OSURoboticsClub/aerial_avionics/README.md

Aerial Avionics
===============
_Hardware design files for aerial team avionics_
