OSURoboticsClub/aerial_avionics/(threads)

Thread 5 (2015-01-25):

Replace reset pullup with 4.7k resistor

yoos, 2015-01-25:
20k is too high

Thread 6 (2015-01-25):

Move 3.3V via out from under MPU-9250.

yoos, 2015-01-25:
The MPU-9250 has a large center pad which could short the 3.3V plane with GND. This would be bad.

yoos, 2016-01-28:
Done.

Closed 2016-01-28.

Thread 10 (2015-01-29):

Fix MPU-9250 footprint

yoos, 2015-01-29:
New package is 3x3x1mm QFN, unlike the 4x4x0.9mm QFN the MPU-6000 was.

yoos, 2016-01-28:
Done.

Closed 2016-01-28.

Thread 11 (2015-01-29):

Better connect component side sensor 3.3V plane to 3.3V bus

yoos, 2015-01-29:
Currently connected to copper side 3.3V plane by a pad 1 of MPU-9250. After cutting that trace to accommodate the MPU-6000, 3.3V plane is cut off. This plane should have been better connected anyway. Should be easier to do on 4-layer board.

Thread 13 (2015-02-02):

Replace uSD CD pullup with 1.5k resistor

yoos, 2015-02-02:
1.5k already used for I2C and USB, so might as well do this to reduce part count.

Thread 14 (2015-02-05):

Add LED button to indicate data save location

yoos, 2015-02-05:
Some flights are more worth saving than others. We should toggle this on the FC board with a button with LED feedback.

Thread 15 (2015-02-05):

Add LED button to arm/disarm board

yoos, 2015-02-05:
At least for rocket, need to be able to arm on pad. Thinking a stiff button accessible via a LED-lighted pinhole.

Thread 16 (2015-02-07):

Replace crystal oscillator with MEMS resonator

yoos, 2015-02-07:
MEMS resonators are temperature-compensated. They are more jittery, but we care more about long-term drift issues rather than small edge-to-edge clock jitter.

Thread 17 (2015-02-07):

Invert TX/RX LED logic levels

yoos, 2015-02-07:
UART is active low. TX/RX status LEDs should be inverted.

yoos, 2015-02-07:
Actually, no.

Closed 2015-02-07.

Thread 18 (2015-04-08):

Break out 3.3V on some pin

yoos, 2015-04-08:
We just have a bunch of 5V outputs. Maybe this should be the function of the PDB, but it's nice for debugging external peripherals.

Thread 19 (2015-04-08):

Reroute KILL bus to mechanical switch instead of XBee

yoos, 2015-04-08:
Also put digital outputs on KILL bus with DNP resistors.

yoos, 2016-04-05:
This was started to comply with IARC requirement. It's a dumb requirement.

Closed 2016-04-05.

Thread 21 (2015-04-14):

Add 100 Ohm series resistors to MOSI and SCK on SPI1 and SPI2

yoos, 2015-04-14:
Edges are overshooting by more than 800mV. The MS5611 and MPU-9050 on one of the boards died recently, and I suspect the overly strong line drivers in the F4. Adding resistors close to the F4 fixed the overshoot.

yoos, 2015-04-19:
Scoped unterminated lines with better probe, and there doesn't seem to be any ringing at all. I think the overshoot is just an artifact. That said, it's still not a bad idea to add them..

Thread 22 (2015-05-17):

Add series power FETs in line with servo output power rails

yoos, 2015-05-17:
Servos hold position when a previously active signal disappears. Without access to the internal circuitry, I can't think of an easier way to make a servo go limp.
