OSURoboticsClub/aerial_avionics/motor_controller/rev1/P1/esc_mod1_p1.pdf

D

6 | 5 | 4 | 3 | 2 | 1

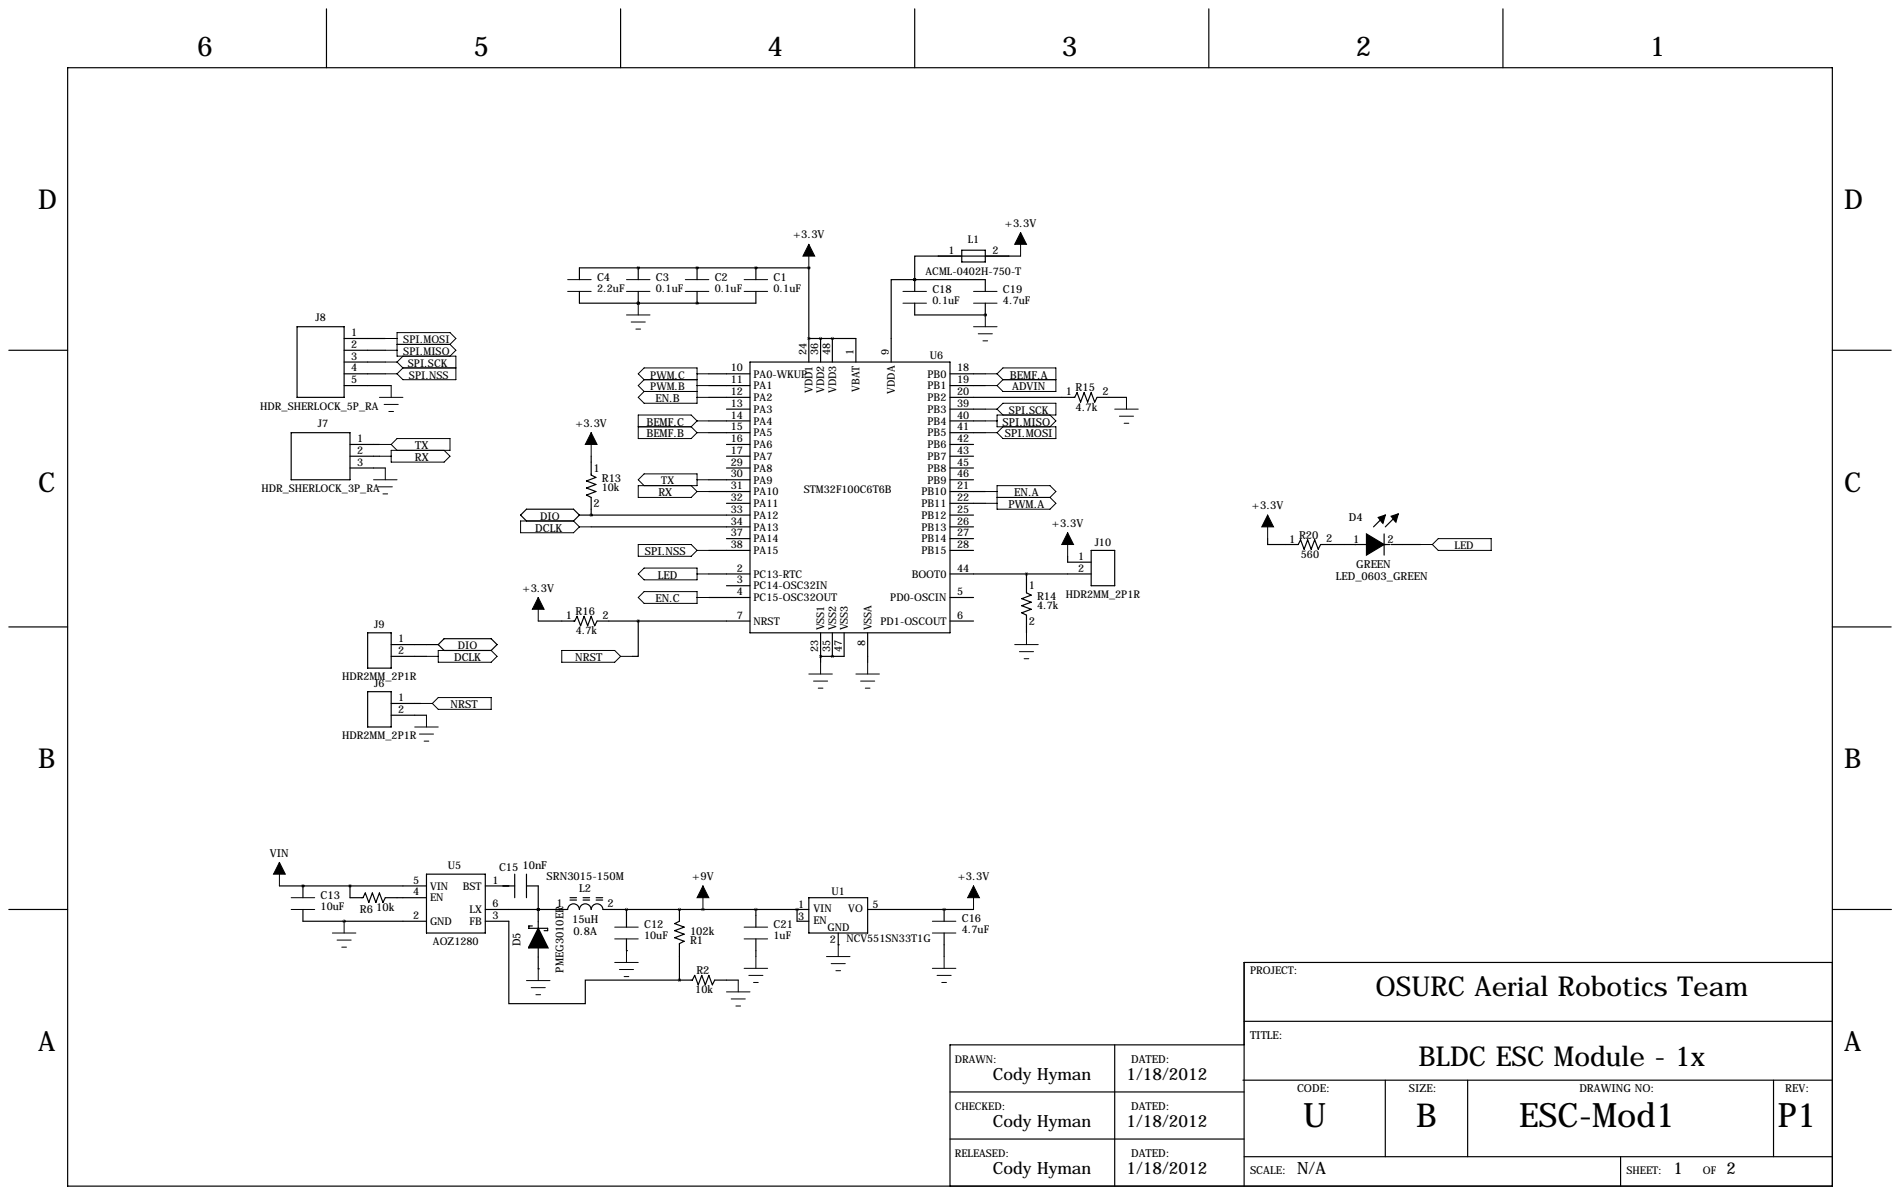
[picture p1: page 1]

OSURC Aerial Robotics Team

DRAWN: Cody Hyman | DATED: 1/18/2012

CODE: U | SIZE: B | DRAWING NO: ESC-Mod1 | REV: P1

CHECKED: Cody Hyman | DATED: 1/18/2012

RELEASED: Cody Hyman | DATED: 1/18/2012

N/A SCALE: | 1 2 SHEET: OF

# BACD

6

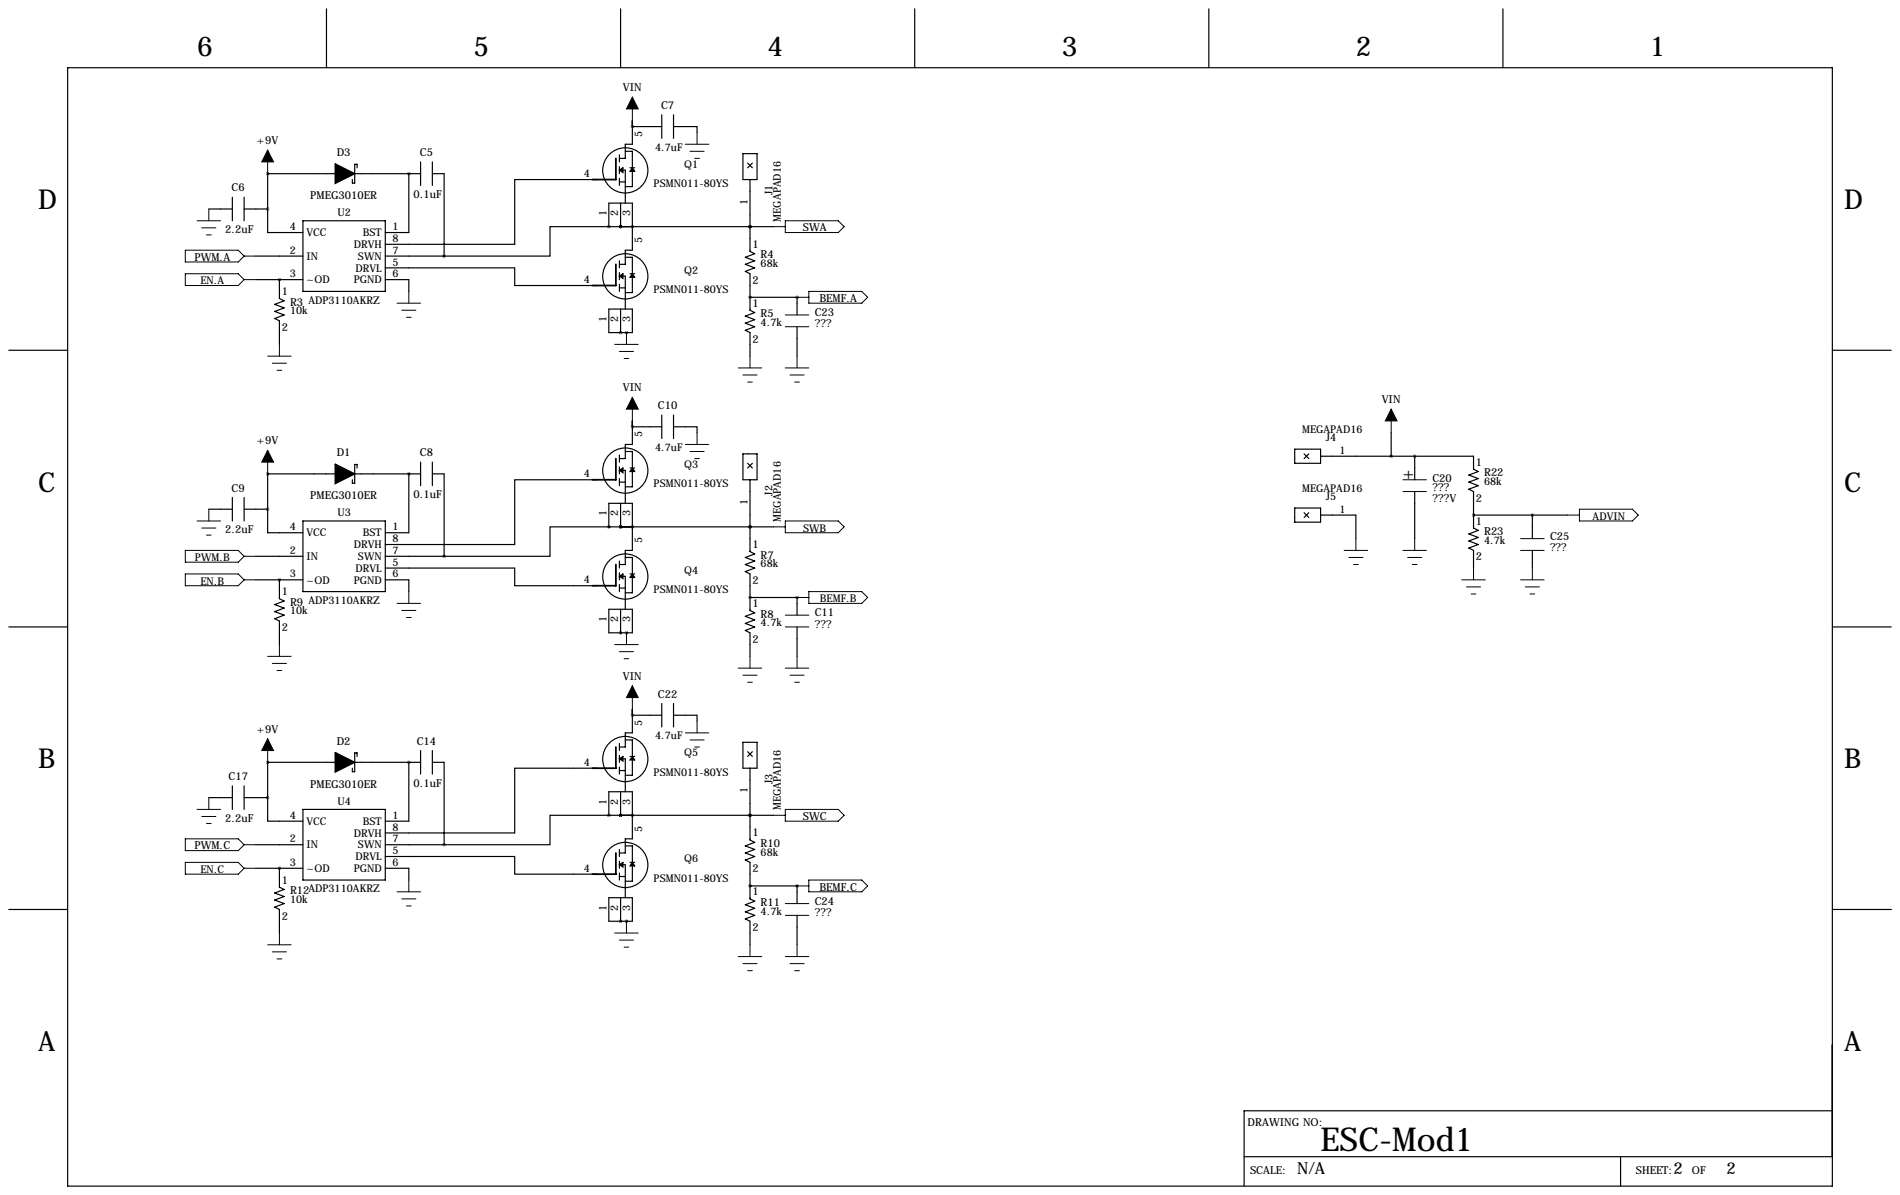
[picture p2: page 2]
