OSURoboticsClub/aerial_avionics/flight_controller/v3.9/core_v3.9_layout.pdf

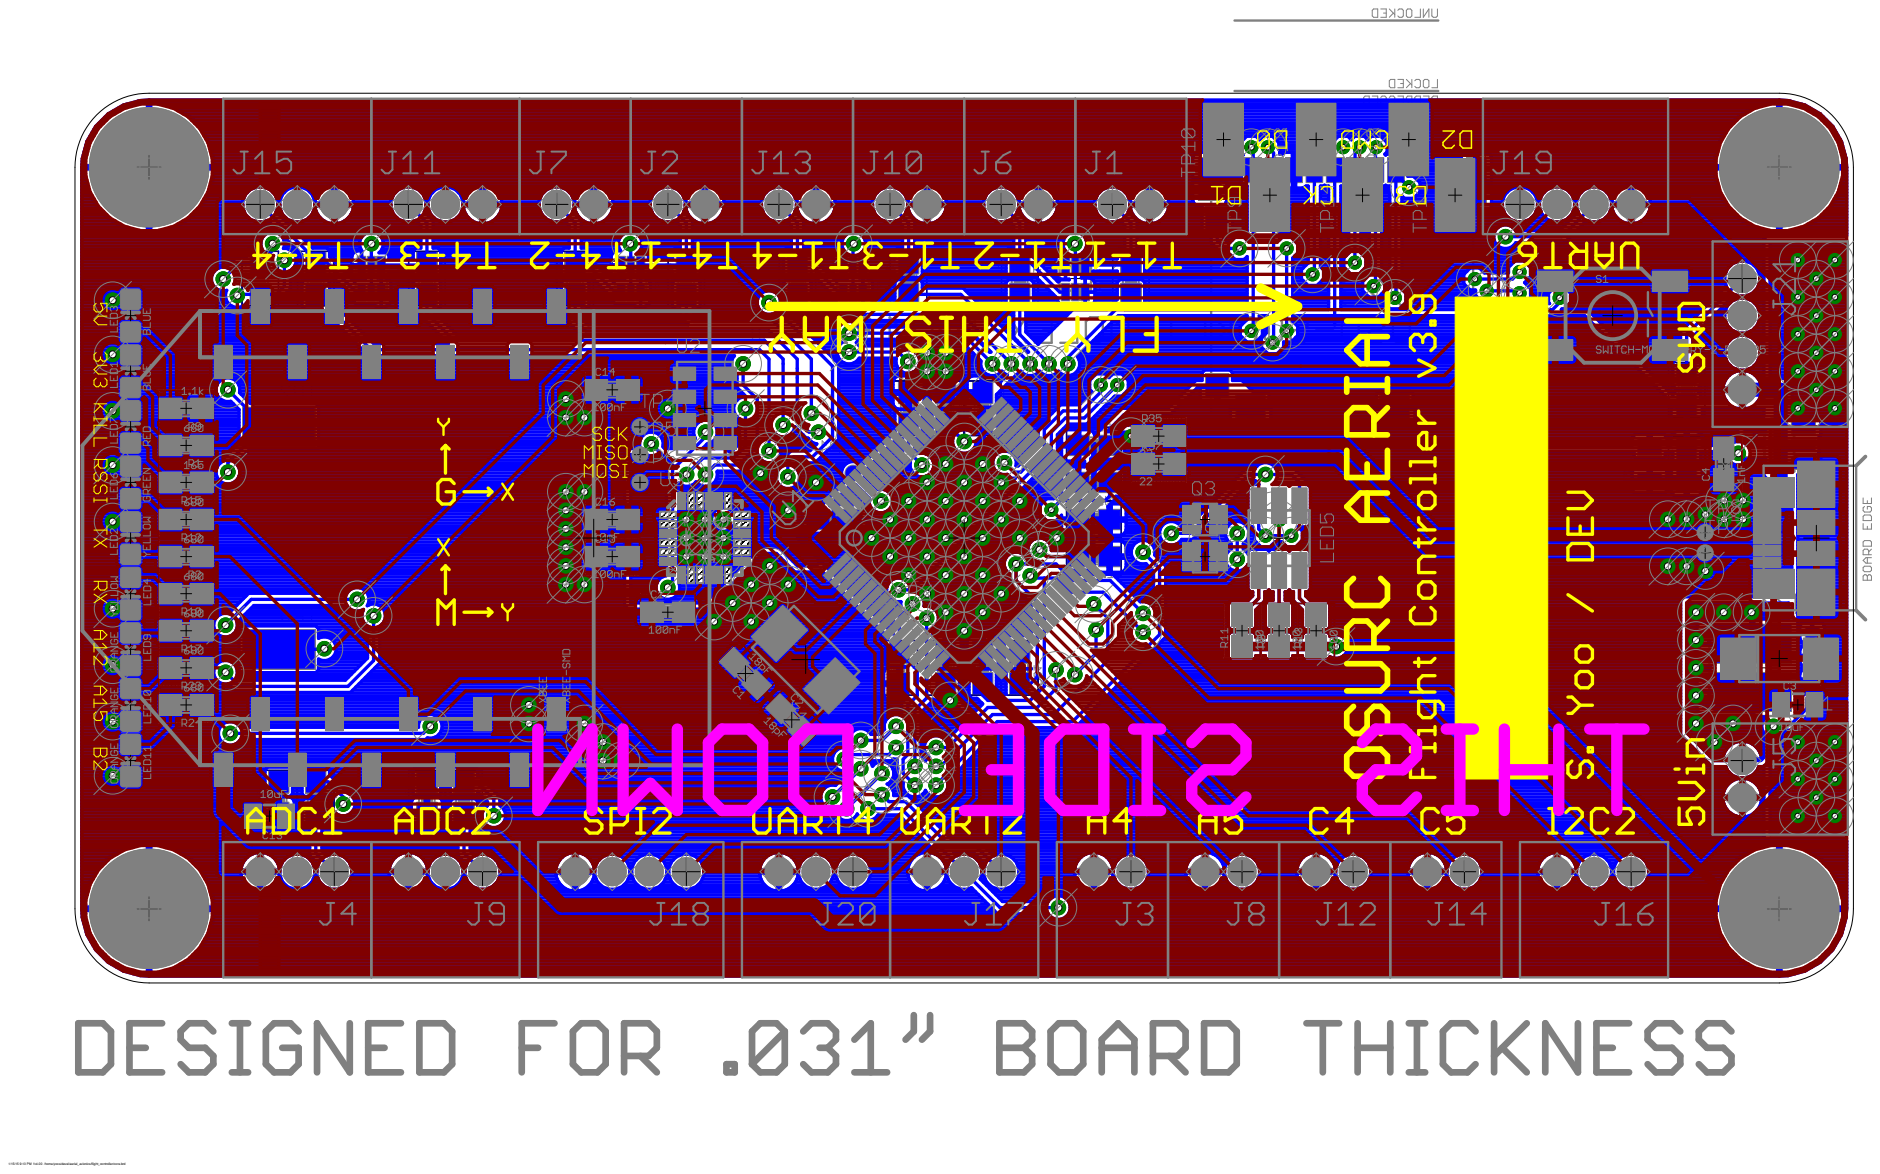
[picture p3: page 1]

1/15/15 9:13 PM f=4.00 /home/yoos/devel/aerial_avionics/flight_controller/core.brd
