OSURoboticsClub/aerial_avionics/flight_controller/v3.9/core_v3.9_sch.pdf

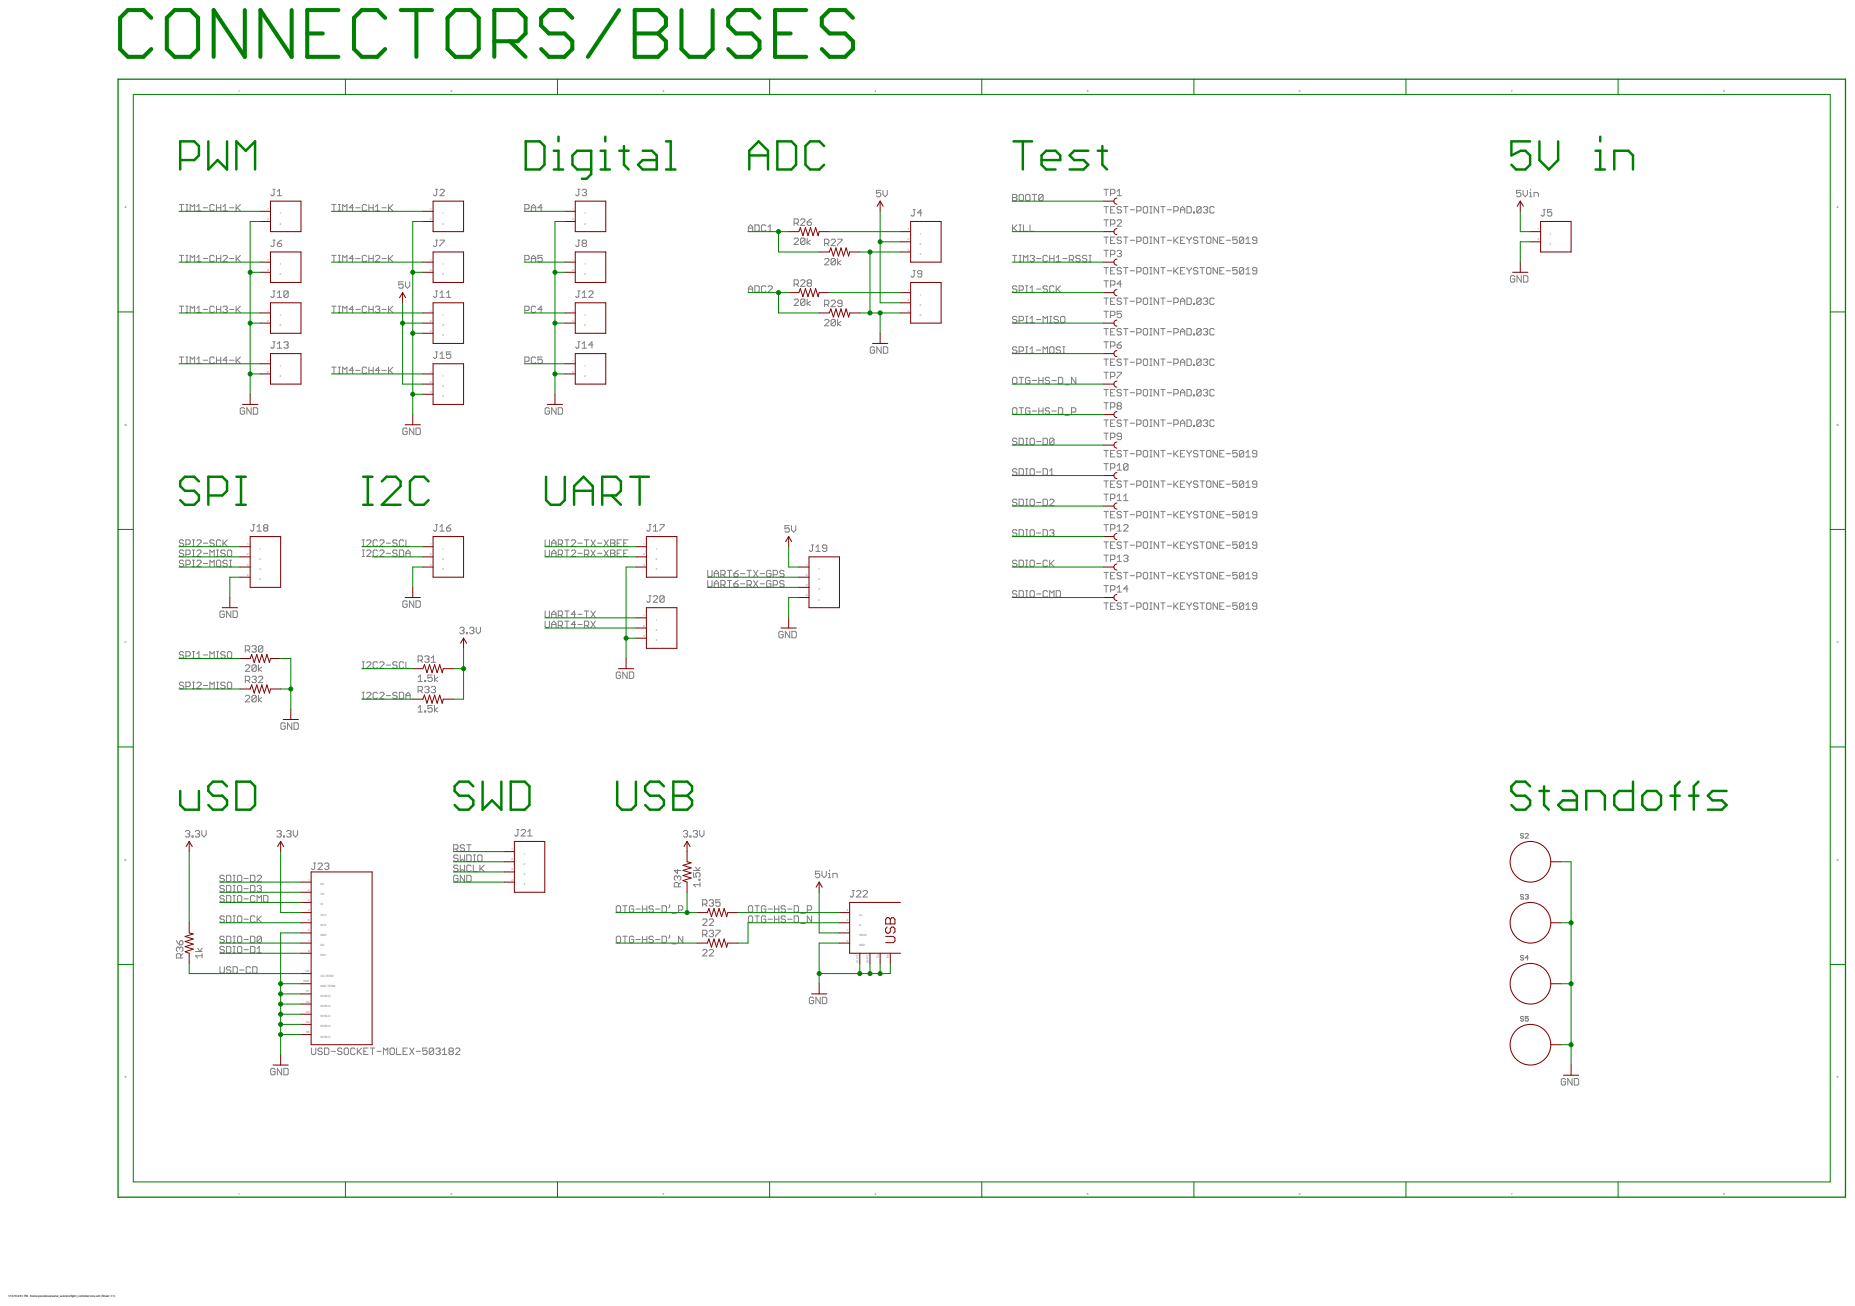
[picture p4: page 1]

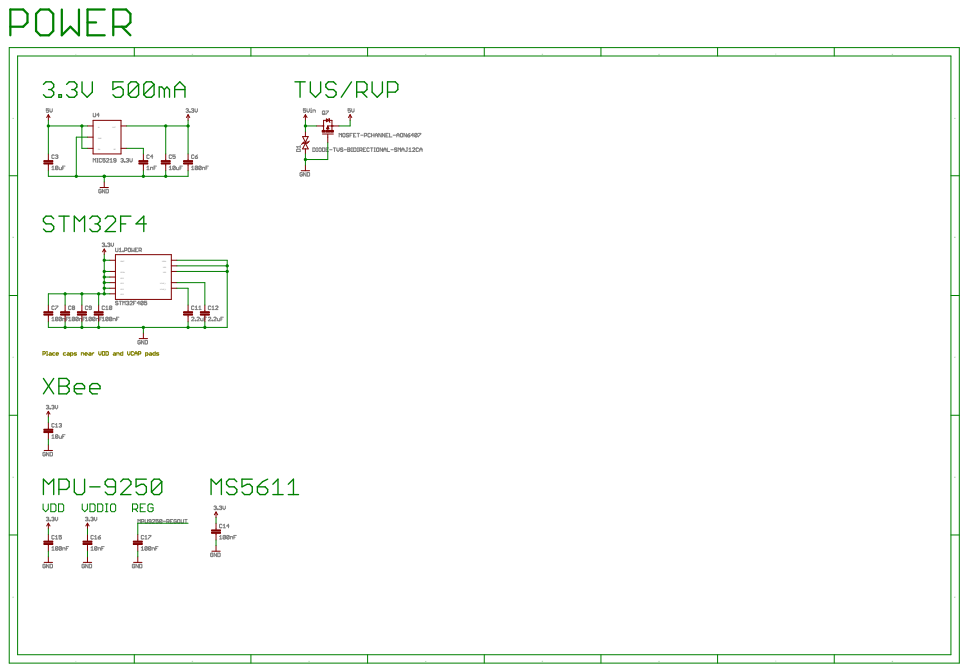
[picture p5: page 2]

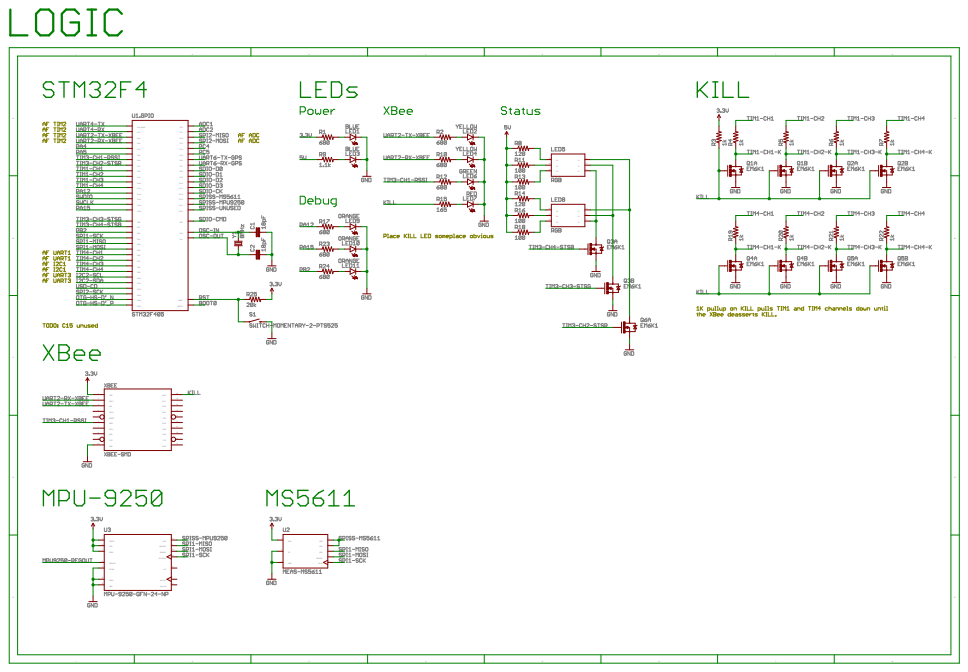
[picture p6: page 3]
