OSURoboticsClub/aerial_avionics/motor_controller/rev1/P1/esc_mod1_p1_layout.pdf

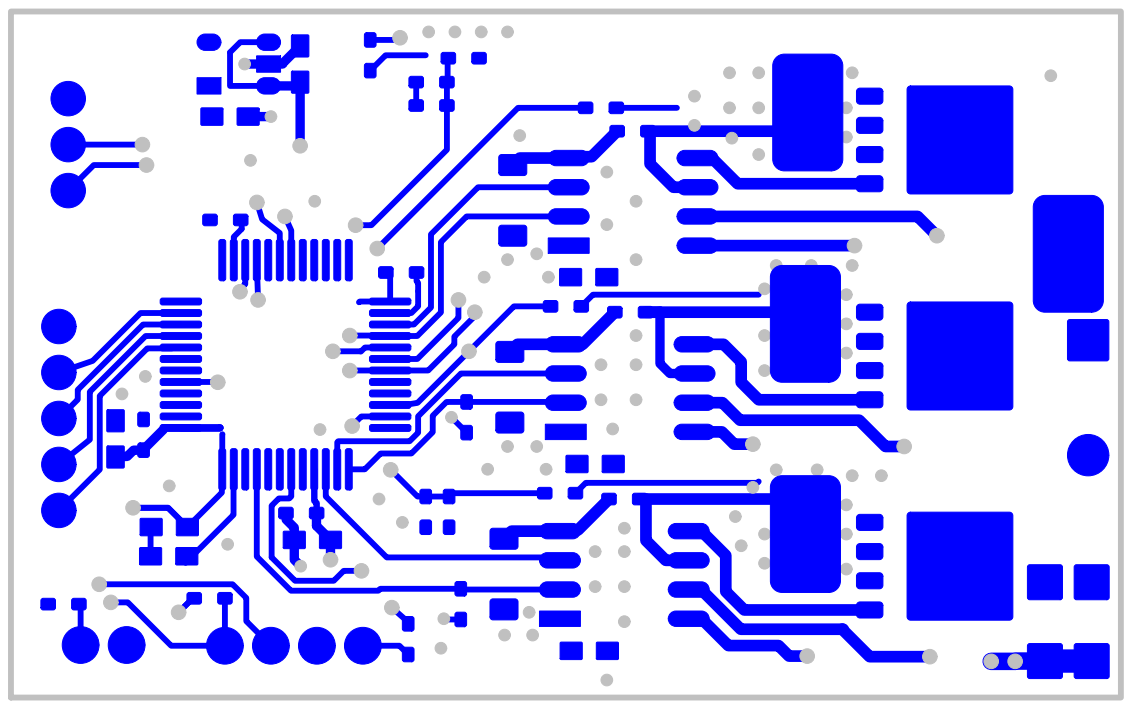
[picture p7: page 1]

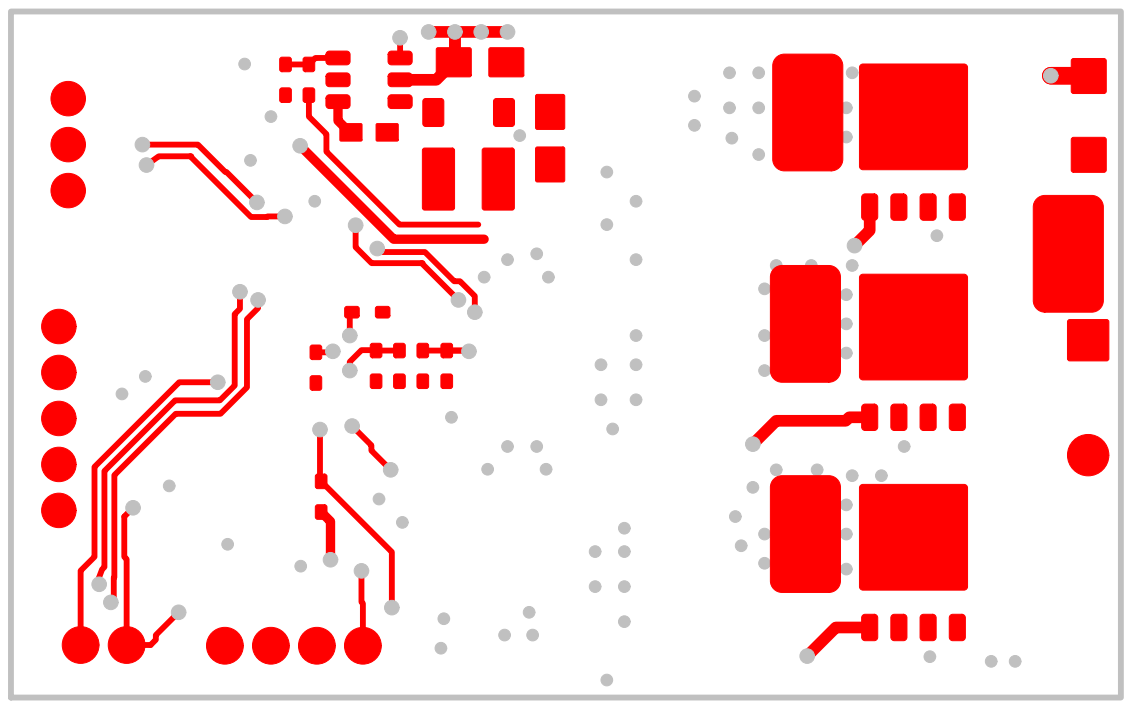
[picture p8: page 2]
U5U⁵x1 U⁵x2 U⁵x3; U⁵x4 U⁵x5 U⁵x6; C11C¹¹x1; C15C¹⁵x1; C¹⁵x2; C12C¹²x1 C¹²x2; C13C¹³x1; C¹³x2; C7C⁷x1 C⁷x2 C20C²⁰x1 C²⁰x2; Q2Q²x4; Q²x3; Q²x2; Q²x1 Q²x5; Q4Q⁴x4; Q⁴x3; Q⁴x2; Q⁴x1 Q⁴x5; Q6Q⁶x4; Q⁶x3; Q⁶x2; Q⁶x1 Q⁶x5; R1R¹x1; R3R³x1; R³x2; R5R⁵x1 R⁵x2; R8R⁸x1 R⁸x2; D5D⁵x1; D⁵x2; R15R¹⁵x1 R¹⁵x2

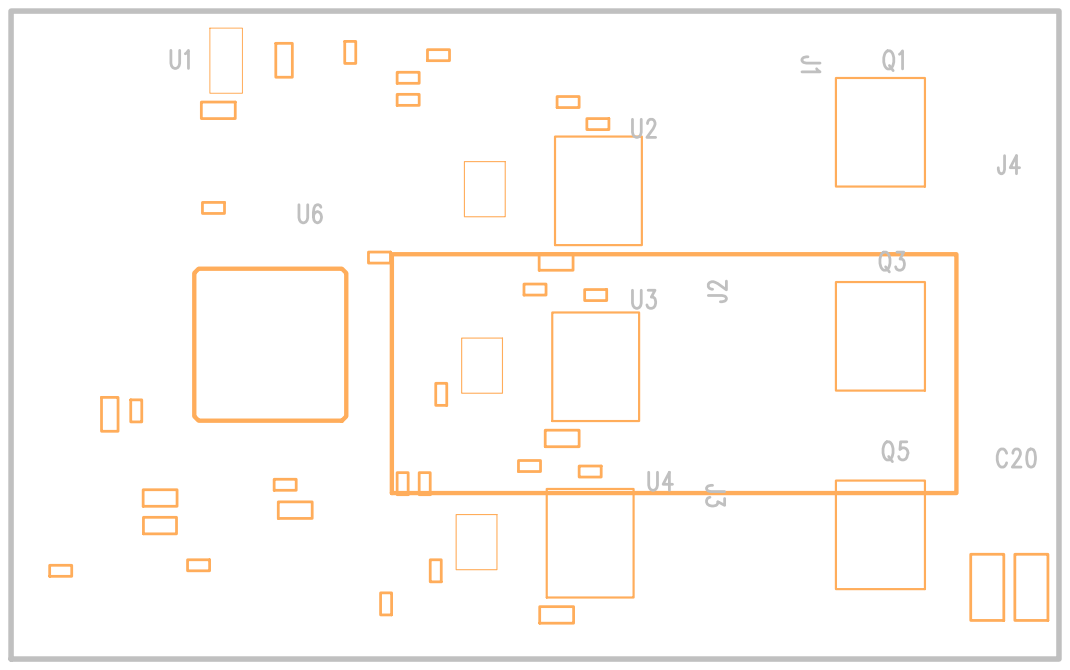
[picture p9: page 3]

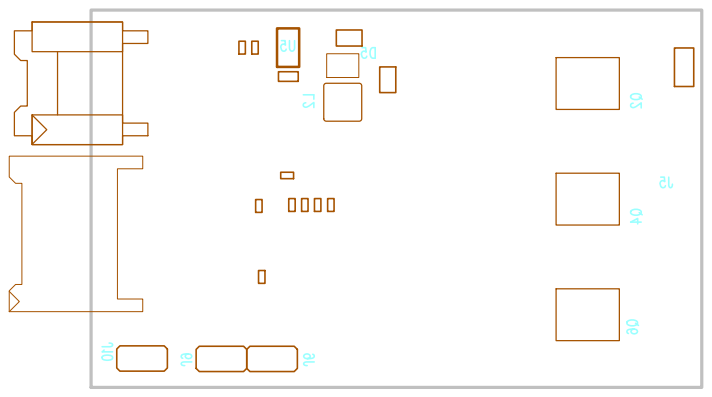
[picture p10: page 4]

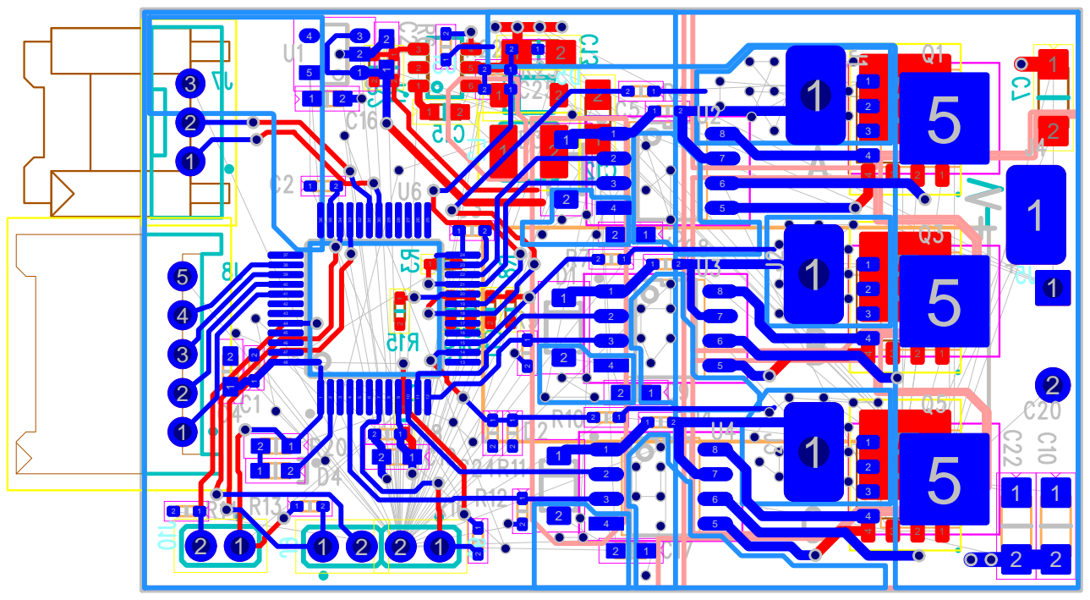
[picture p11: page 5]
