OSURoboticsClub/aerial_avionics/(list of files, drawings)

Other design files:
motor_controller/rev1/esc_mod1_p1.pcb
motor_controller/rev2/esc_mod1_p2.pcb
