OSURoboticsClub/aerial_avionics/power_distribution/osuar_pdb.brd

## EAGLE design power_distribution/osuar_pdb.brd (2016-01-24)

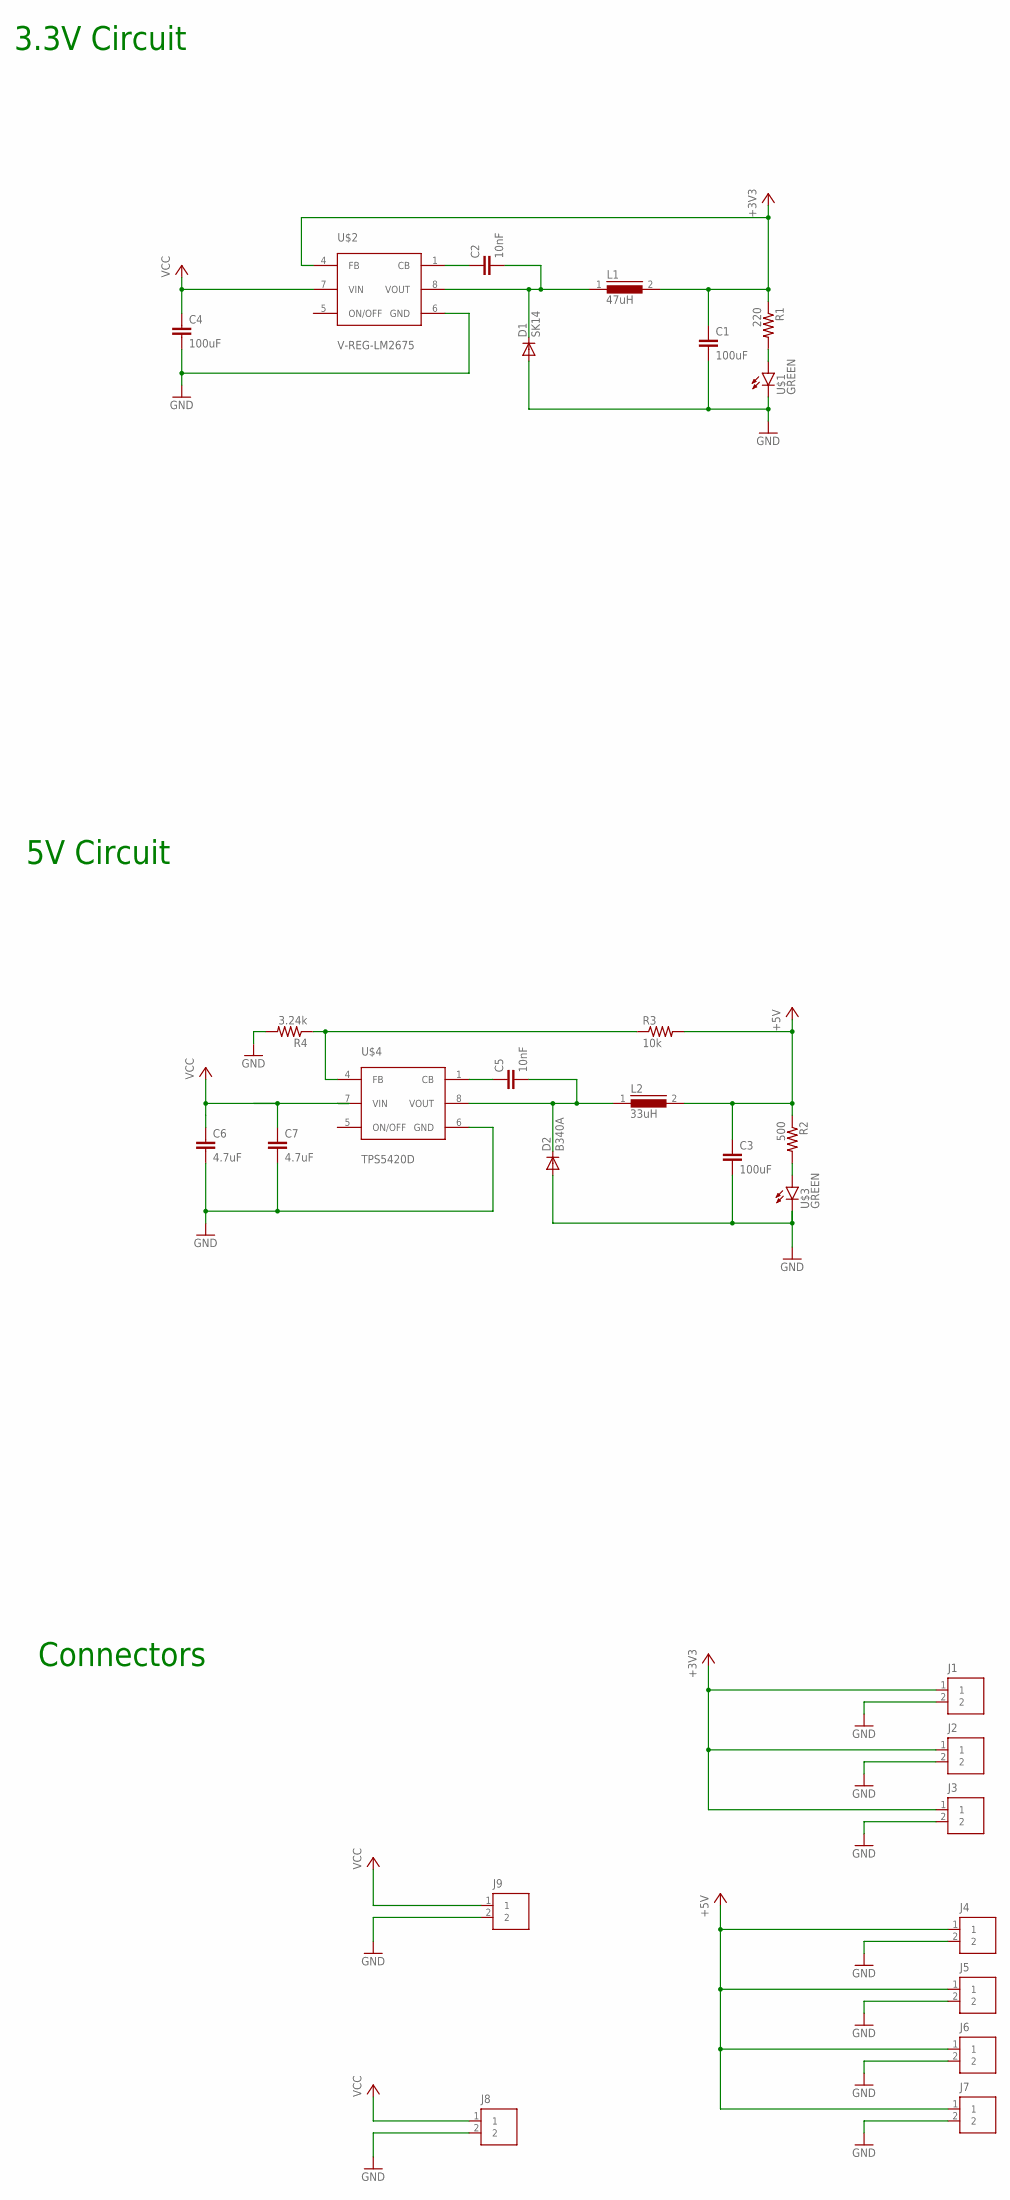
[picture p12: schematic osuar_pdb.sch, 3.3V Circuit]

Parts:
C1, C3, C4: 100uF; 0805
C2, C5: 10nF; 0603
C6, C7: 4.7uF; 0805
D1: SK14; DO214AA
D2: B340A; DO214AA
J1, J2, J3, J4, J5, J6, J7, J8, J9: M02; MOLEX-2MM-MICROLATCH-2POS-RA
L1: 47uH; DR125
L2: 33uH; DR125
R1: 220; 0603
R2: 500; 0603
R3: 10k; 0603
R4: 3.24k; 0603
U$1, U$3: GREEN; LED-0603
U$2: V-REG-LM2675; SOIC8
U$4: TPS5420D; SOIC8

Connections:
+3V3: C1.2, J1.1, J2.1, J3.1, L1.2, R1.1, U$2.4 (FB)
+5V: C3.2, J4.1, J5.1, J6.1, J7.1, L2.2, R2.1, R3.2
GND: C1.1, C3.1, C4.1, C6.1, C7.1, D1.A, D2.A, J1.2, J2.2, J3.2, J4.2, J5.2, J6.2, J7.2, J8.2, J9.2, R4.2, U$1.C, U$2.6 (GND), U$3.C, U$4.6 (GND)
unnamed: C5.1, D2.C, L2.1, U$4.8 (VOUT)
unnamed: C2.2, U$2.1 (CB)
unnamed: R1.2, U$1.A
unnamed: C5.2, U$4.1 (CB)
unnamed: C2.1, D1.C, L1.1, U$2.8 (VOUT)
unnamed: R2.2, U$3.A
unnamed: R3.1, R4.1, U$4.4 (FB)
VCC: C4.2, C6.2, C7.2, J8.1, J9.1, U$2.7 (VIN), U$4.7 (VIN)

Notes on the sheet:
3.3V Circuit
5V Circuit
Connectors

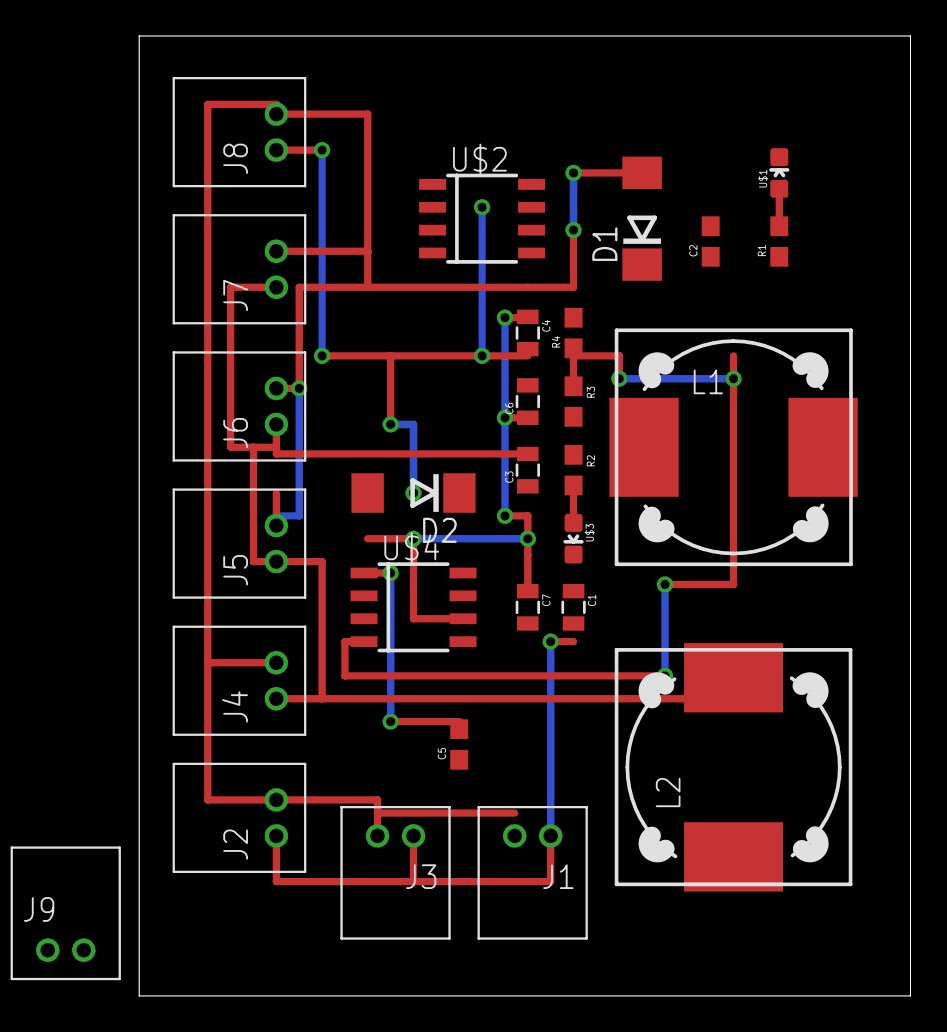
[picture p13: board osuar_pdb.brd from above]

Board: 2 copper layers, 42.9 x 53.3 mm, 28 parts (0 on the bottom side), 11 nets.
