OSURoboticsClub/aerial_avionics/flight_controller/v3.9.1/core.brd

## EAGLE design flight_controller/v3.9.1/core.brd (2016-01-24)

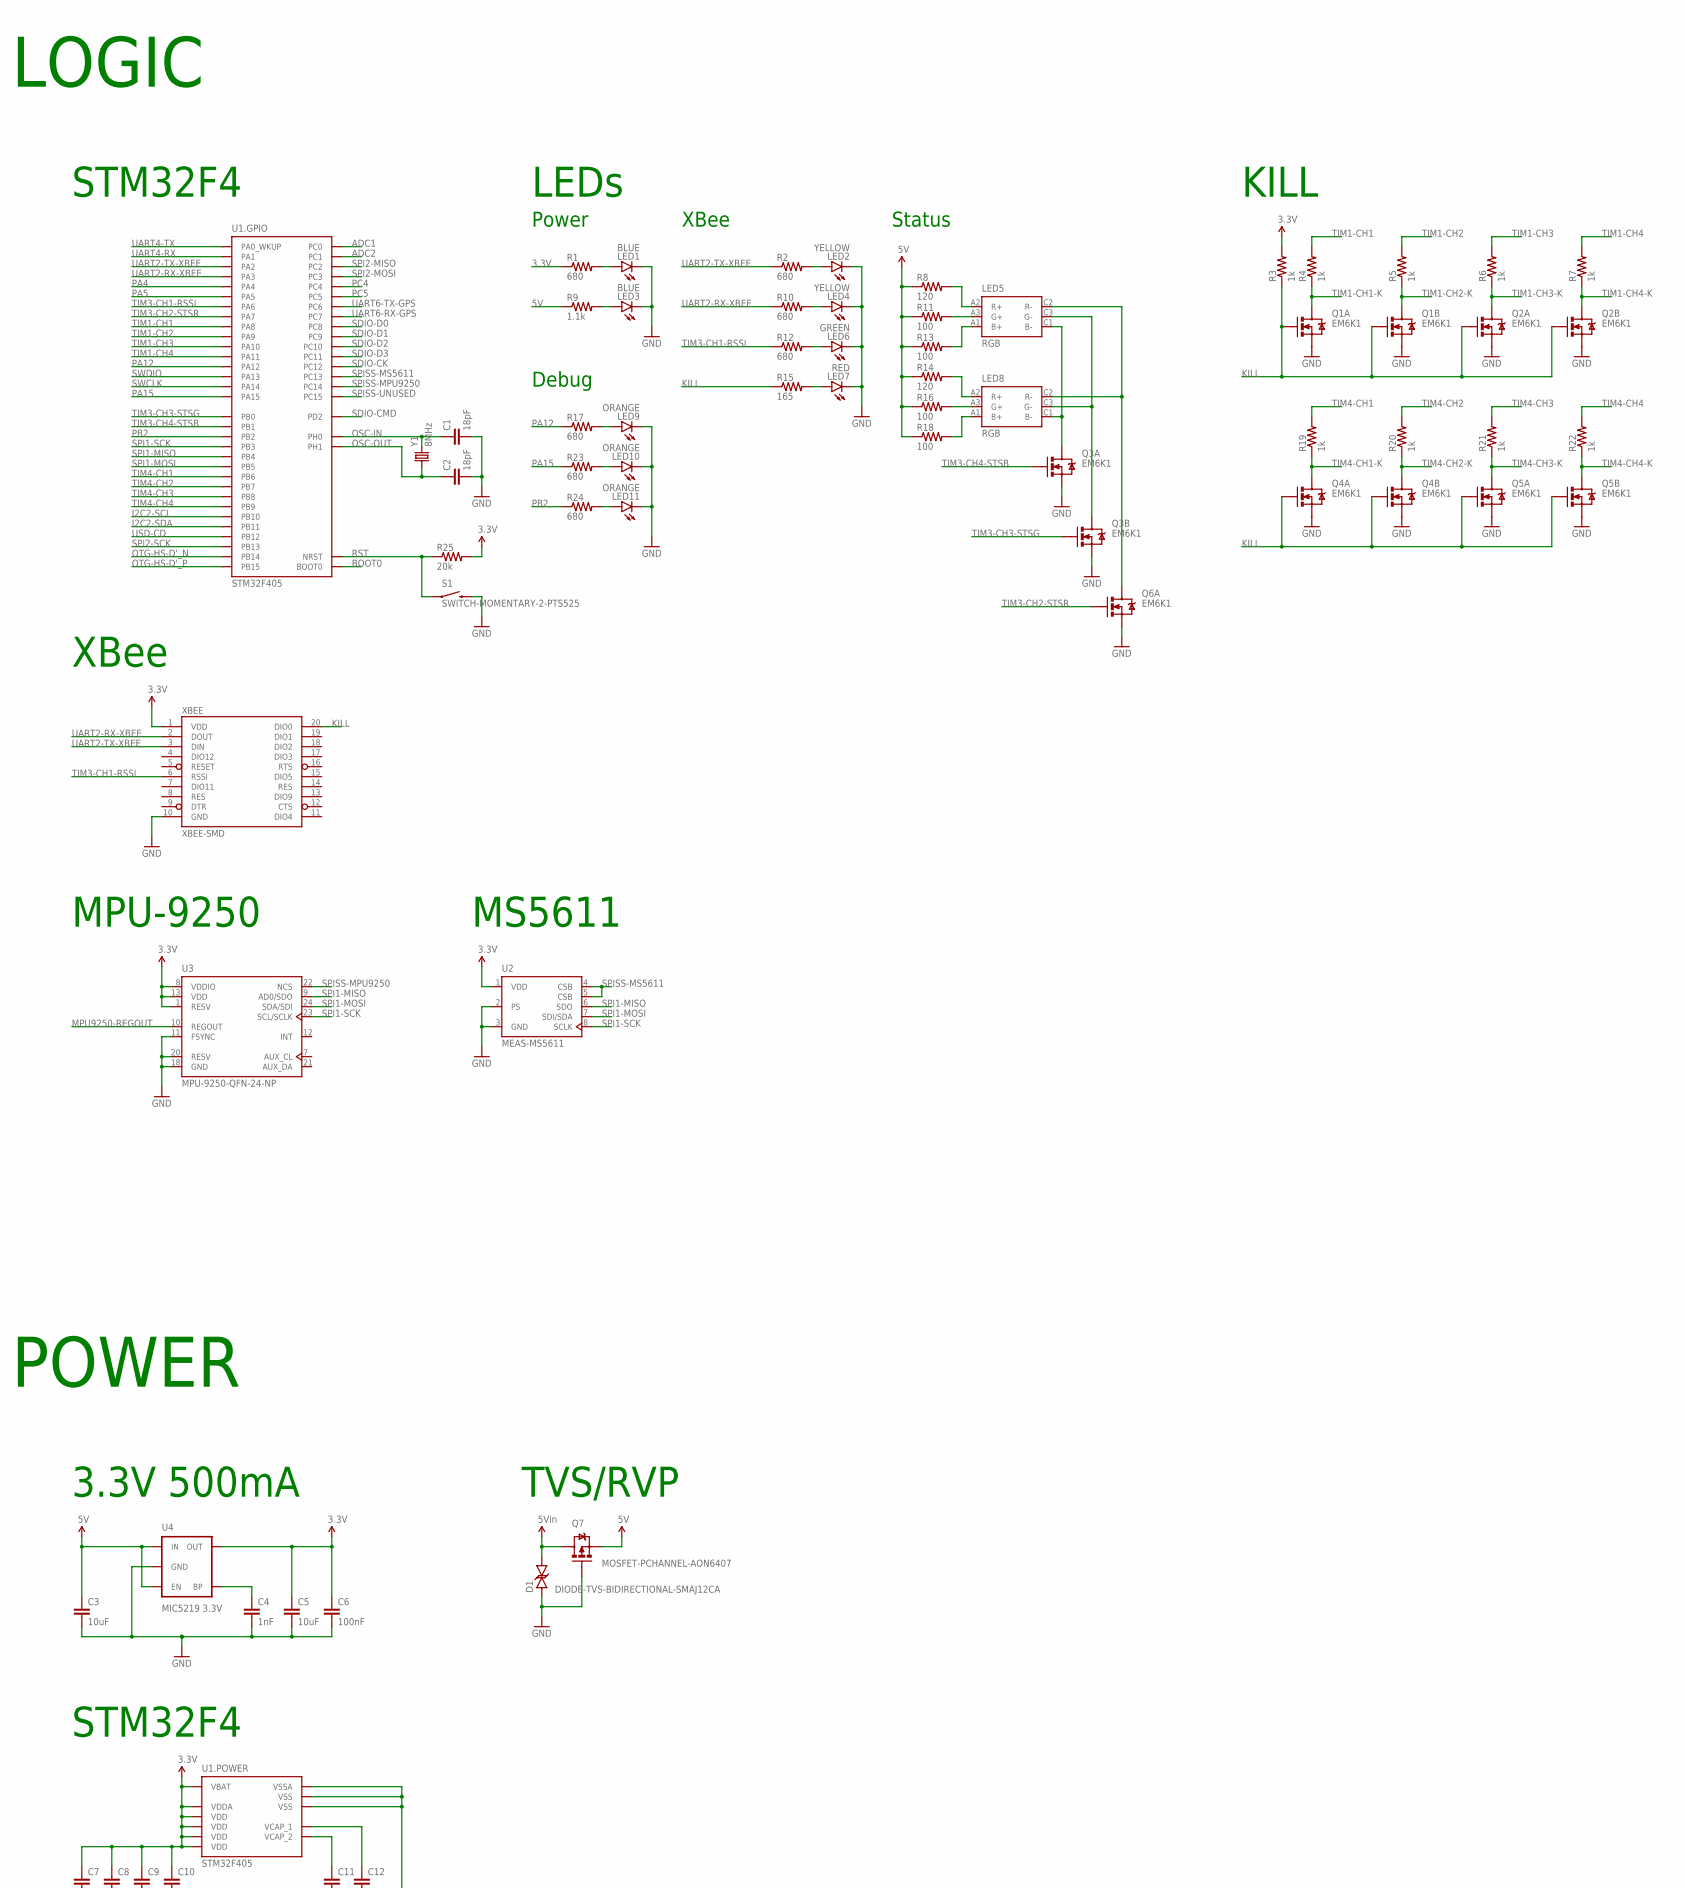
[picture p14: schematic core.sch, part in row 1, column 1]

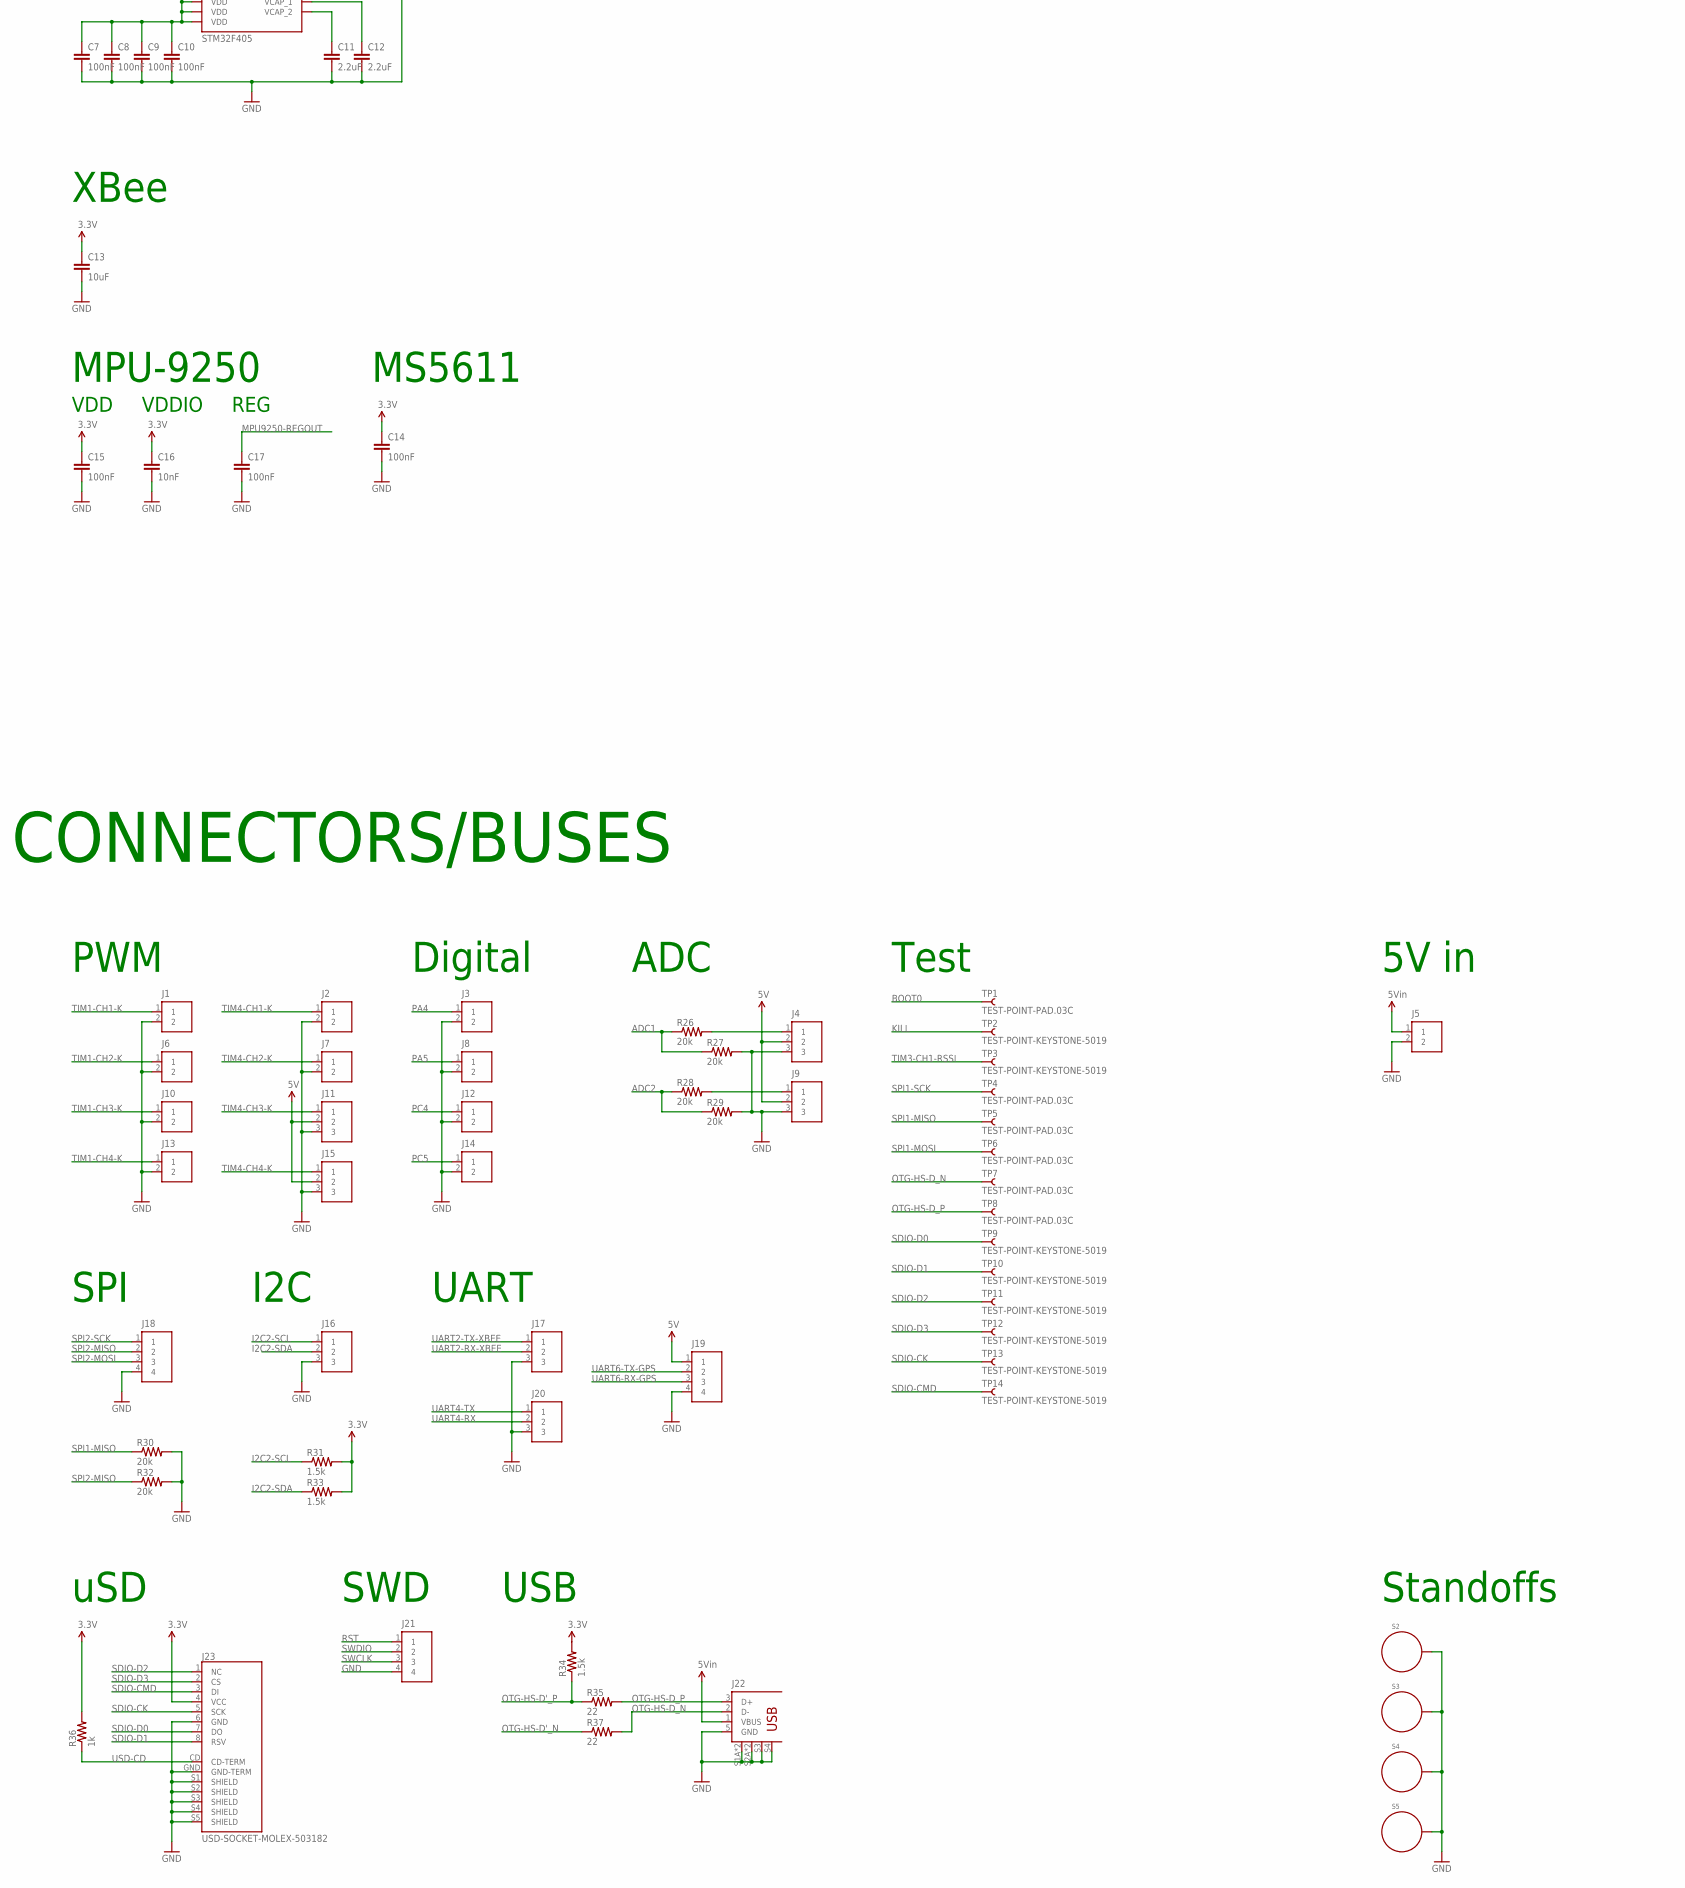
[picture p15: schematic core.sch, part in row 2, column 1]

Parts:
C1, C2: 18pF; 0603
C3, C5, C13: 10uF; 0805
C4: 1nF; 0603
C6, C7, C8, C9, C10, C14, C15, C17: 100nF; 0603
C11, C12: 2.2uF; 0603
C16: 10nF; 0603
D1: DIODE-TVS-BIDIRECTIONAL-SMAJ12CA; SMAJ
J1, J2, J3, J5, J6, J7, J8, J10, J12, J13, J14: M02; MOLEX-2MM-MICROLATCH-2POS-RA
J4, J9, J11, J15, J16, J17, J20: M03; MOLEX-2MM-MICROLATCH-3POS-RA
J18, J19, J21: M04; MOLEX-2MM-MICROLATCH-4POS-RA
J22: USB+SHIELD-MICROB-SMD-MOLEX; USB-MICROB-SMD-MOLEX
J23: USD-SOCKET-MOLEX-503182; USD-SOCKET-PP-MOLEX-503182
LED1, LED3: BLUE; LED-0603
LED2, LED4: YELLOW; LED-0603
LED5, LED8: RGB; PLCC-6
LED6: GREEN; LED-0603
LED7: RED; LED-0603
LED9, LED10, LED11: ORANGE; LED-0603
Q1, Q2, Q3, Q4, Q5, Q6: EM6K1; SOT-666
Q7: MOSFET-PCHANNEL-AON6407; DFN5X6
R1, R2, R10, R12, R17, R23, R24: 680; 0603
R3, R4, R5, R6, R7, R19, R20, R21, R22, R36: 1k; 0603
R8, R14: 120; 0603
R9: 1.1k; 0603
R11, R13, R16, R18: 100; 0603
R15: 165; 0603
R25, R26, R27, R28, R29, R30, R32: 20k; 0603
R31, R33, R34: 1.5k; 0603
R35, R37: 22; 0603
S1: SWITCH-MOMENTARY-2-PTS525; TACTILE-SWITCH-SMD
S2, S3, S4, S5: STANDOFF_ELECTRICAL-#4; STANDOFF-ELECTRICAL-#4
TP1, TP4, TP5, TP6, TP7, TP8: TEST-POINT-PAD.03C; PAD-.03C
TP2, TP3, TP9, TP10, TP11, TP12, TP13, TP14: TEST-POINT-KEYSTONE-5019; PAD.15X.08
U1: STM32F405; LQFP-64-STM32F405
U2: MEAS-MS5611
U3: MPU-9250-QFN-24-NP; QFN-24-NP-3X3MM
U4: MIC5219 3.3V; SOT23-5
XBEE: XBEE-SMD
Y1: 8MHz; CX532

Connections:
3.3V: C5.2, C6.2, C7.2, C8.2, C9.2, C10.2, C13.2, C14.2, C15.2, C16.2, J23.4 (VCC), R1.1, R3.2, R25.2, R31.2, R33.2, R34.2, R36.2, U1.1 (VBAT), U1.13 (VDDA), U1.19 (VDD), U1.32 (VDD), U1.48 (VDD), U1.64 (VDD), U2.1 (VDD), U3.1 (RESV), U3.8 (VDDIO), U3.13 (VDD), U4.5 (OUT), XBEE.1 (VDD)
5V: C3.2, J4.2, J9.2, J11.2, J15.2, J19.1, Q7.1 (S), Q7.2 (S), Q7.3 (S), R8.1, R9.1, R11.1, R13.1, R14.1, R16.1, R18.1, U4.1 (IN), U4.3 (EN)
ADC1: R26.1, R27.1, U1.8 (PC0)
ADC1-IN: J4.1, R26.2
ADC2: R28.1, R29.1, U1.9 (PC1)
ADC2-IN: J9.1, R28.2
BOOT0: TP1.1, U1.60 (BOOT0)
F4-VCAP-1: C11.2, U1.47 (VCAP_2)
F4-VCAP-2: C12.2, U1.31 (VCAP_1)
GND: C1.1, C2.1, C3.1, C4.1, C5.1, C6.1, C7.1, C8.1, C9.1, C10.1, C11.1, C12.1, C13.1, C14.1, C15.1, C16.1, C17.1, D1.A (1), J1.2, J2.2, J3.2, J4.3, J5.2, J6.2, J7.2, J8.2, J9.3, J10.2, J11.3, J12.2, J13.2, J14.2, J15.3, J16.3, J17.3, J18.4, J19.4, J20.3, J21.4, J22.5 (GND), J22.S1A (S1), J22.S1B (S1), J22.S2A (S2), J22.S2B (S2), J22.S3, J22.S4, J23.6 (GND), J23.GND (GND-TERM), J23.S1 (SHIELD), J23.S2 (SHIELD), J23.S3 (SHIELD), J23.S4 (SHIELD), J23.S5 (SHIELD), LED1.C, LED2.C, LED3.C, LED4.C, LED6.C, LED7.C, LED9.C, LED10.C, LED11.C, Q1.1 (S), Q1.4 (S), Q2.1 (S), Q2.4 (S), Q3.1 (S), Q3.4 (S), Q4.1 (S), Q4.4 (S), Q5.1 (S), Q5.4 (S), Q6.1 (S), Q7.4 (G), R27.2, R29.2, R30.2, R32.2, S1.3 (2), S1.4 (2), S2.P1, S3.P1, S4.P1, S5.P1, U1.12 (VSSA), U1.18 (VSS), U1.63 (VSS), U2.2 (PS), U2.3 (GND), U3.11 (FSYNC), U3.18 (GND), U3.20 (RESV), U4.2 (GND), XBEE.10 (GND)
I2C2-SCL: J16.1, R31.1, U1.29 (PB10)
I2C2-SDA: J16.2, R33.1, U1.30 (PB11)
KILL: Q1.2 (G), Q1.5 (G), Q2.2 (G), Q2.5 (G), Q4.2 (G), Q4.5 (G), Q5.2 (G), Q5.5 (G), R3.1, R15.1, TP2.1, XBEE.20 (DIO0)
MIC-BP: C4.2, U4.4 (BP)
MPU9250-REGOUT: C17.2, U3.10 (REGOUT)
unnamed: LED9.A, R17.2
unnamed: LED10.A, R23.2
unnamed: LED11.A, R24.2
unnamed: LED6.A, R12.2
unnamed: LED7.A, R15.2
unnamed: LED2.A, R2.2
unnamed: LED4.A, R10.2
unnamed: LED1.A, R1.2
unnamed: LED3.A, R9.2
OSC-IN: C1.2, U1.5 (PH0), Y1.2
OSC-OUT: C2.2, U1.6 (PH1), Y1.1
OTG-HS-D'_N: R37.1, U1.35 (PB14)
OTG-HS-D'_P: R34.1, R35.1, U1.36 (PB15)
OTG-HS-D_N: J22.2 (D-), R37.2, TP7.1
OTG-HS-D_P: J22.3 (D+), R35.2, TP8.1
PA4: J3.1, U1.20 (PA4)
PA5: J8.1, U1.21 (PA5)
PA12: R17.1, U1.45 (PA12)
PA15: R23.1, U1.50 (PA15)
PB2: R24.1, U1.28 (PB2)
PC4: J12.1, U1.24 (PC4)
PC5: J14.1, U1.25 (PC5)
RST: J21.1, R25.1, S1.1, S1.2 (1), U1.7 (NRST)
SDIO-CK: J23.5 (SCK), TP13.1, U1.53 (PC12)
SDIO-CMD: J23.3 (DI), TP14.1, U1.54 (PD2)
SDIO-D0: J23.7 (DO), TP9.1, U1.39 (PC8)
SDIO-D1: J23.8 (RSV), TP10.1, U1.40 (PC9)
SDIO-D2: J23.1 (NC), TP11.1, U1.51 (PC10)
SDIO-D3: J23.2 (CS), TP12.1, U1.52 (PC11)
SPI1-MISO: R30.1, TP5.1, U1.56 (PB4), U2.6 (SDO), U3.9 (AD0/SDO)
SPI1-MOSI: TP6.1, U1.57 (PB5), U2.7 (SDI/SDA), U3.24 (SDA/SDI)
SPI1-SCK: TP4.1, U1.55 (PB3), U2.8 (SCLK), U3.23 (SCL/SCLK)
SPI2-MISO: J18.2, R32.1, U1.10 (PC2)
SPI2-MOSI: J18.3, U1.11 (PC3)
SPI2-SCK: J18.1, U1.34 (PB13)
SPISS-MPU9250: U1.3 (PC14), U3.22 (NCS)
SPISS-MS5611: U1.2 (PC13), U2.4 (CSB), U2.5 (CSB)
SPISS-UNUSED: U1.4 (PC15)
STSB1+: LED5.A1 (B+), R13.2
STSB2+: LED8.A1 (B+), R18.2
STSB-: LED5.C1 (B-), LED8.C1 (B-), Q3.6 (D)
STSG1+: LED5.A3 (G+), R11.2
STSG2+: LED8.A3 (G+), R16.2
STSG-: LED5.C3 (G-), LED8.C3 (G-), Q3.3 (D)
STSR1+: LED5.A2 (R+), R8.2
STSR2+: LED8.A2 (R+), R14.2
STSR-: LED5.C2 (R-), LED8.C2 (R-), Q6.6 (D)
SWCLK: J21.3, U1.49 (PA14)
SWDIO: J21.2, U1.46 (PA13)
TIM1-CH1: R4.2, U1.41 (PA8)
TIM1-CH1-K: J1.1, Q1.6 (D), R4.1
TIM1-CH2: R5.2, U1.42 (PA9)
TIM1-CH2-K: J6.1, Q1.3 (D), R5.1
TIM1-CH3: R6.2, U1.43 (PA10)
TIM1-CH3-K: J10.1, Q2.6 (D), R6.1
TIM1-CH4: R7.2, U1.44 (PA11)
TIM1-CH4-K: J13.1, Q2.3 (D), R7.1
TIM3-CH1-RSSI: R12.1, TP3.1, U1.22 (PA6), XBEE.6 (RSSI)
TIM3-CH2-STSR: Q6.2 (G), U1.23 (PA7)
TIM3-CH3-STSG: Q3.5 (G), U1.26 (PB0)
TIM3-CH4-STSB: Q3.2 (G), U1.27 (PB1)
TIM4-CH1: R19.2, U1.58 (PB6)
TIM4-CH1-K: J2.1, Q4.6 (D), R19.1
TIM4-CH2: R20.2, U1.59 (PB7)
TIM4-CH2-K: J7.1, Q4.3 (D), R20.1
TIM4-CH3: R21.2, U1.61 (PB8)
TIM4-CH3-K: J11.1, Q5.6 (D), R21.1
TIM4-CH4: R22.2, U1.62 (PB9)
TIM4-CH4-K: J15.1, Q5.3 (D), R22.1
UART2-RX-XBEE: J17.2, R10.1, U1.17 (PA3), XBEE.2 (DOUT)
UART2-TX-XBEE: J17.1, R2.1, U1.16 (PA2), XBEE.3 (DIN)
UART4-RX: J20.2, U1.15 (PA1)
UART4-TX: J20.1, U1.14 (PA0_WKUP)
UART6-RX-GPS: J19.3, U1.38 (PC7)
UART6-TX-GPS: J19.2, U1.37 (PC6)
USD-CD: J23.CD (CD-TERM), R36.1, U1.33 (PB12)
VIN: D1.C (2), J5.1, J22.1 (VBUS), Q7.5 (D), Q7.6 (D), Q7.7 (D), Q7.8 (D), Q7.9 (D), Q7.10 (D)

Notes on the sheet:
3.3V 500mA
XBee
ADC
UART
PWM
SWD
KILL
STM32F4
LOGIC
POWER
USB
uSD
CONNECTORS/BUSES
LEDs
Debug
Power
MPU-9250
MS5611
SPI
I2C
Status
5V in
TVS/RVP
VDD
REG
VDDIO
Digital
Test
Standoffs

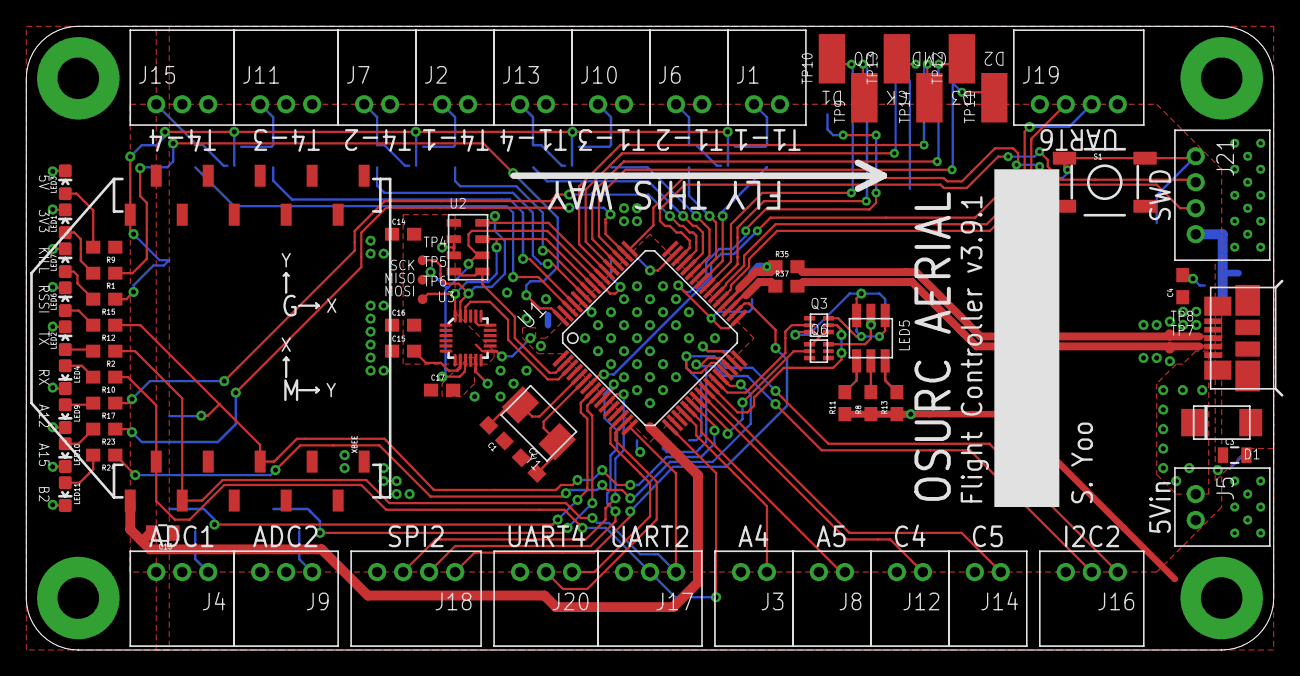
[picture p16: board core.brd from above]

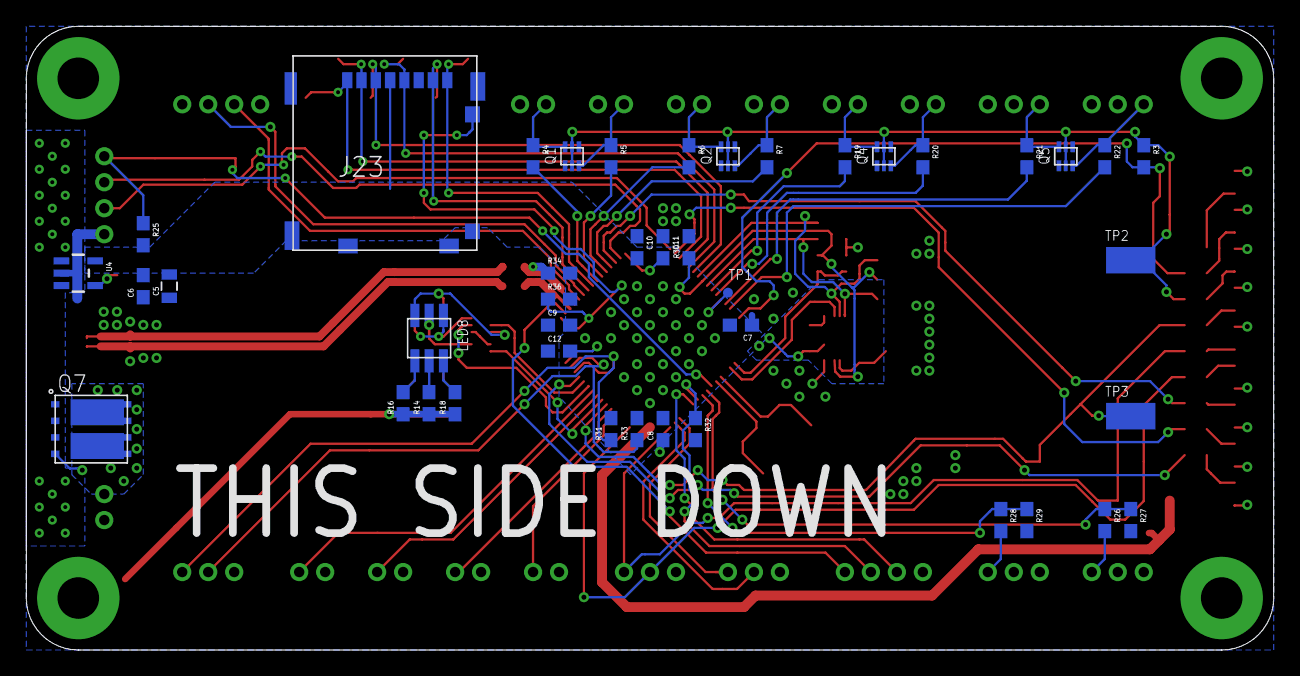
[picture p17: board core.brd from below]

Board: 2 copper layers, 96.0 x 48.0 mm, 121 parts (42 on the bottom side), 91 nets.
