OSURoboticsClub/aerial_avionics/flight_controller/rev2/was_not_root_aerialboard_rev1.brd

## EAGLE design flight_controller/rev2/was_not_root_aerialboard_rev1.brd (2014-11-05, an earlier design)

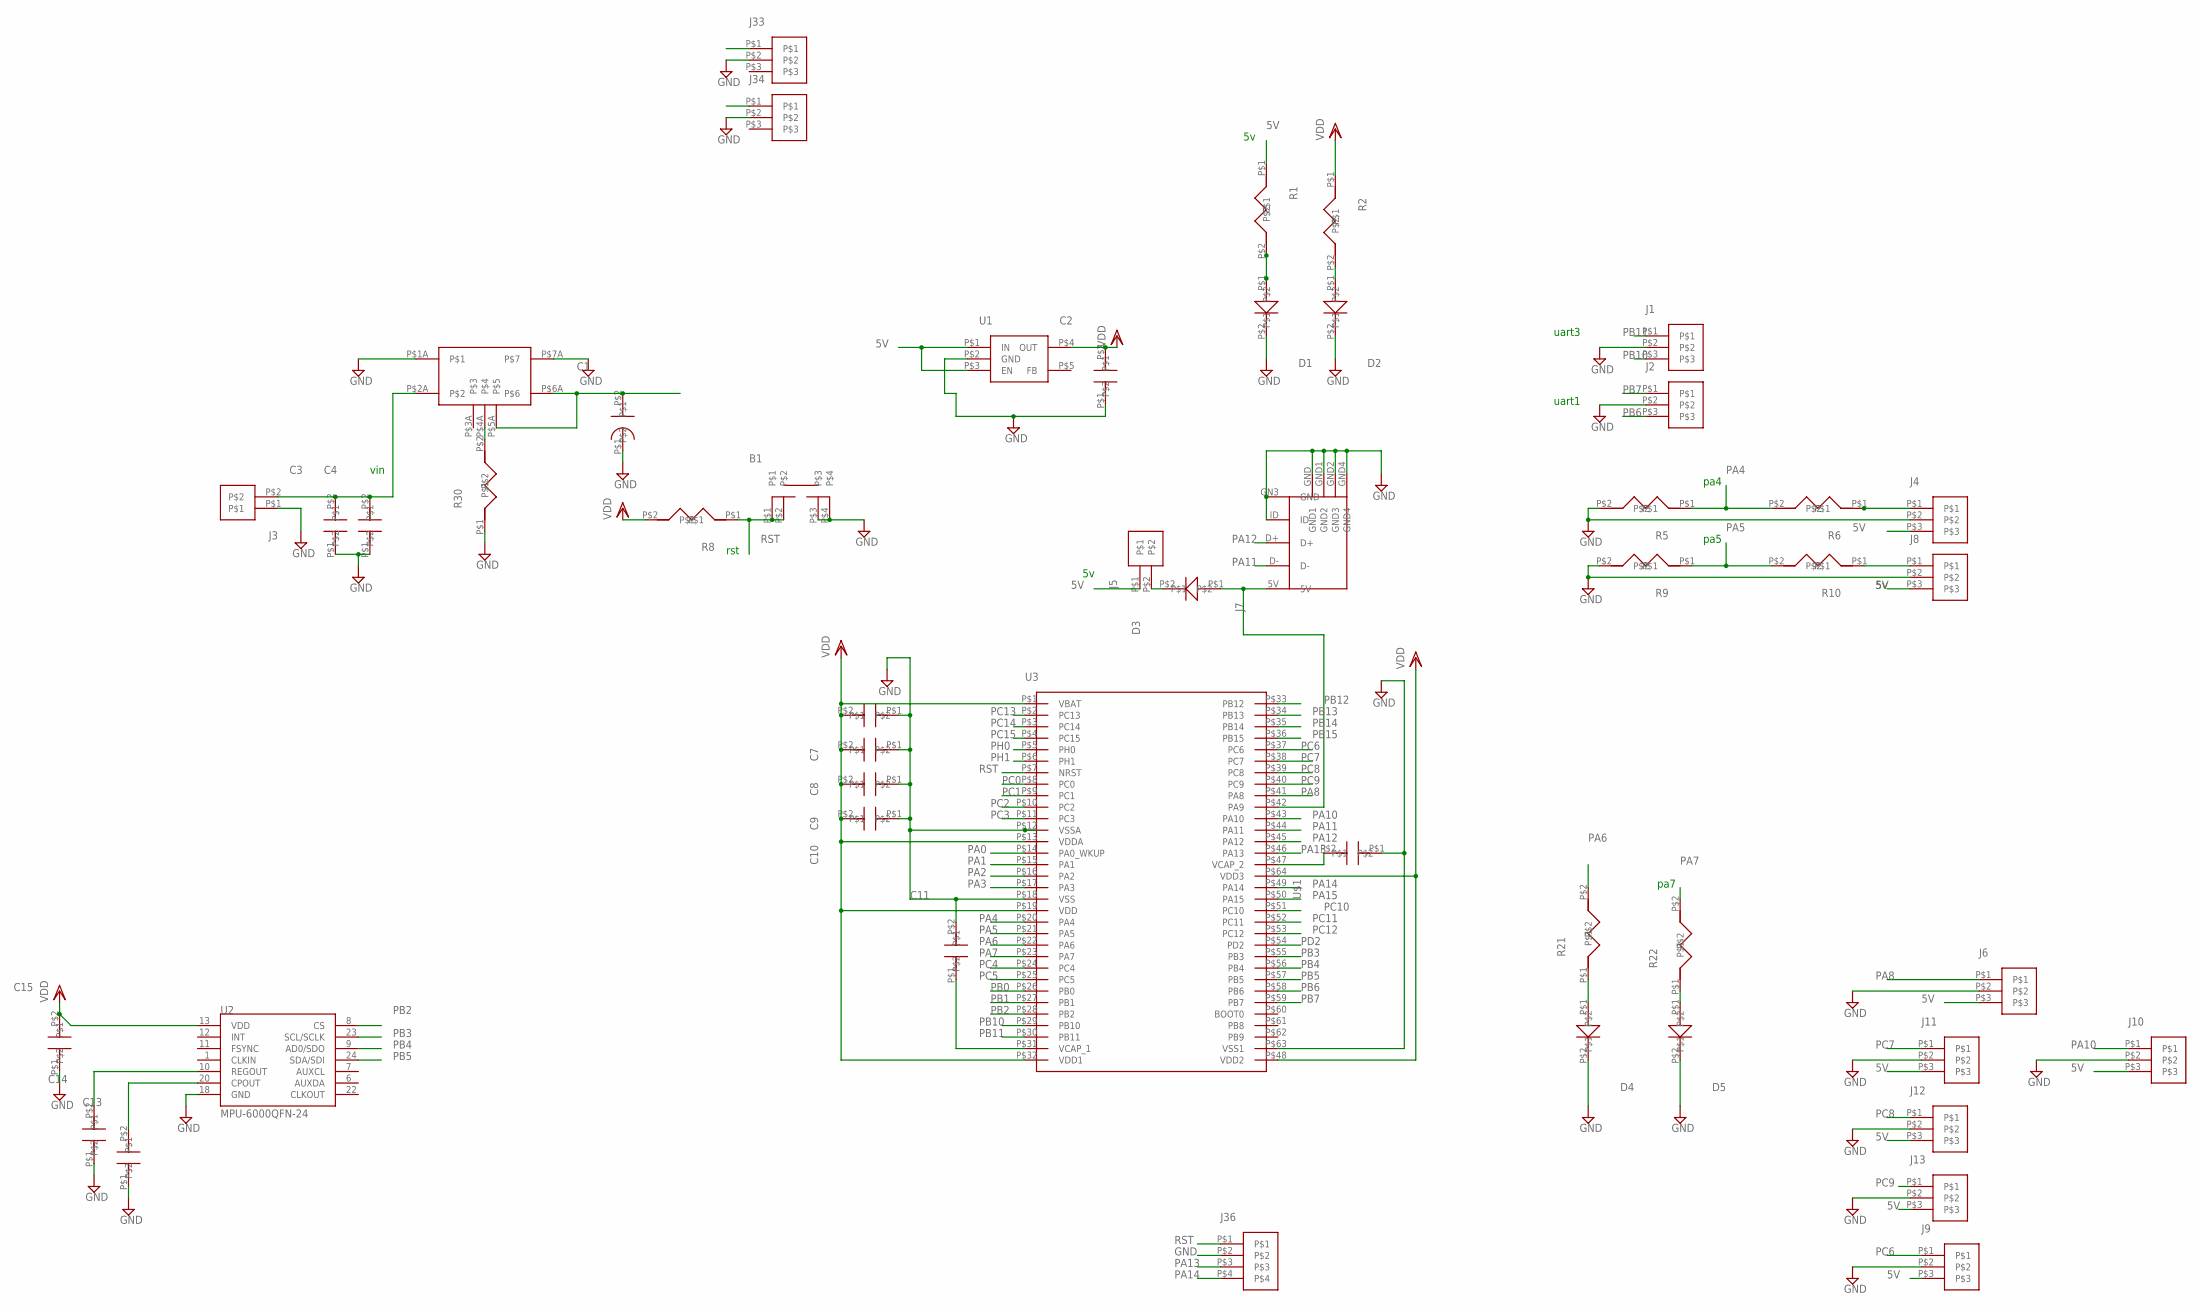
[picture p18: schematic was_not_root_aerialboard_rev1.sch]

Parts:
B1: SM-BUTTON; SM_BUTTON
C1: CAPACITOR-330UF; 330UF-CAPACITOR
C2, C3, C4, C11: 2.2UF-CAP; 0603-CAPACITOR
C7, C8, C9, C14, C15: CAPACITOR-.1UF-4V; 0603-CAPACITOR
C10: 4.7UF-CAP6.3V; 0603-CAPACITOR
C13: CAPACITOR-2.2NF-50V; 0603-CAPACITOR
D1, D2, D4: RED_LED; 0603-CAPACITOR
D3: B240A-DIODE; DIODE-DS13004
D5: ORANGE_LED; 0603-CAPACITOR
J1, J2, J4, J6, J8, J9, J10, J11, J12, J13: 3-PIN-SHERLOCK; 3-PIN-2MM
J3: 2-PIN-POWER; 2-PIN-3MM
J5: 2-PIN-100MIL; 2PIN-100MIL
J7: USB_MINI_B
J33, J34: 3-PIN-3MM
J36: 4-PIN-SHERLOCK; 4-PIN-2MM
R1, R2, R8, R21, R22: RESISTOR-4.7K-25V; 0603-CAPACITOR
R5, R6, R9, R10: 10K_RESISTOR; 0603-CAPACITOR
R30: 21K_RESISTOR; 0603-CAPACITOR
U1: TPS73433-3.3-REG; TPS73433-SOT5
U2: MPU-6000QFN-24; QFN-24-TESTING
U3: STM32F405RG; LQFP-64-STM32F405
U$1: 2.2UF-CAP; 0603-CAPACITOR
U$2: WIDE_IN_REG

Connections:
5V: C1.P$2, J4.P$3, J5.P$1, J6.P$3, J8.P$3, J9.P$3, J10.P$3, J11.P$3, J12.P$3, J13.P$3, J33.P$1, J34.P$1, R1.P$1, U1.P$1 (IN), U1.P$3 (EN), U$2.P$5A, U$2.P$6A
GND: B1.P$3, B1.P$4, C1.P$1, C2.P$1, C3.P$1, C4.P$1, C7.P$1, C8.P$1, C9.P$1, C10.P$1, C11.P$2, C13.P$1, C14.P$1, C15.P$1, D1.P$2, D2.P$2, D4.P$2, D5.P$2, J1.P$2, J2.P$2, J3.P$1, J4.P$2, J6.P$2, J7.GN3 (GND), J7.GND (GND1), J7.GND1 (GND2), J7.GND2 (GND3), J7.GND4, J7.ID, J8.P$2, J9.P$2, J10.P$2, J11.P$2, J12.P$2, J13.P$2, J33.P$2, J34.P$2, J36.P$2, R5.P$2, R9.P$2, R30.P$1, U1.P$2 (GND), U2.18 (GND), U3.P$12 (VSSA), U3.P$18 (VSS), U3.P$63 (VSS1), U$1.P$1, U$2.P$1A, U$2.P$7A
unnamed: C13.P$2, U2.20 (CPOUT)
unnamed: D3.P$2, J5.P$2
unnamed: J4.P$1, R6.P$1
unnamed: D4.P$1, R21.P$1
unnamed: R30.P$2, U$2.P$4A
unnamed: J8.P$1, R10.P$1
unnamed: D5.P$1, R22.P$1
unnamed: U3.P$47 (VCAP_2), U$1.P$2
unnamed: C11.P$1, U3.P$31 (VCAP_1)
unnamed: D2.P$1, R2.P$2
unnamed: D1.P$1, R1.P$2
unnamed: C14.P$2, U2.10 (REGOUT)
PA0: U3.P$14 (PA0_WKUP)
PA1: U3.P$15 (PA1)
PA2: U3.P$16 (PA2)
PA3: U3.P$17 (PA3)
PA4: R5.P$1, R6.P$2, U3.P$20 (PA4)
PA5: R9.P$1, R10.P$2, U3.P$21 (PA5)
PA6: R21.P$2, U3.P$22 (PA6)
PA7: R22.P$2, U3.P$23 (PA7)
PA8: J6.P$1, U3.P$41 (PA8)
PA9: D3.P$1, J7.5V, U3.P$42 (PA9)
PA10: J10.P$1, U3.P$43 (PA10)
PA11: J7.D-, U3.P$44 (PA11)
PA12: J7.D+, U3.P$45 (PA12)
PA13: J36.P$3, U3.P$46 (PA13)
PA14: J36.P$4, U3.P$49 (PA14)
PA15: U3.P$50 (PA15)
PB0: U3.P$26 (PB0)
PB1: U3.P$27 (PB1)
PB2: U2.8 (CS), U3.P$28 (PB2)
PB3: U2.23 (SCL/SCLK), U3.P$55 (PB3)
PB4: U2.9 (AD0/SDO), U3.P$56 (PB4)
PB5: U2.24 (SDA/SDI), U3.P$57 (PB5)
PB6: J2.P$3, U3.P$58 (PB6)
PB7: J2.P$1, U3.P$59 (PB7)
PB10: J1.P$3, U3.P$29 (PB10)
PB11: J1.P$1, U3.P$30 (PB11)
PB12: U3.P$33 (PB12)
PB13: U3.P$34 (PB13)
PB14: U3.P$35 (PB14)
PB15: U3.P$36 (PB15)
PC0: U3.P$8 (PC0)
PC1: U3.P$9 (PC1)
PC2: U3.P$10 (PC2)
PC3: U3.P$11 (PC3)
PC4: U3.P$24 (PC4)
PC5: U3.P$25 (PC5)
PC6: J9.P$1, U3.P$37 (PC6)
PC7: J11.P$1, U3.P$38 (PC7)
PC8: J12.P$1, U3.P$39 (PC8)
PC9: J13.P$1, U3.P$40 (PC9)
PC10: U3.P$51 (PC10)
PC11: U3.P$52 (PC11)
PC12: U3.P$53 (PC12)
PC13: U3.P$2 (PC13)
PC14: U3.P$3 (PC14)
PC15: U3.P$4 (PC15)
PD2: U3.P$54 (PD2)
PH0: U3.P$5 (PH0)
PH1: U3.P$6 (PH1)
RST: B1.P$1, B1.P$2, J36.P$1, R8.P$1, U3.P$7 (NRST)
VDD: C2.P$2, C7.P$2, C8.P$2, C9.P$2, C10.P$2, C15.P$2, R2.P$1, R8.P$2, U1.P$4 (OUT), U2.13 (VDD), U3.P$1 (VBAT), U3.P$13 (VDDA), U3.P$19 (VDD), U3.P$32 (VDD1), U3.P$48 (VDD2), U3.P$64 (VDD3)
VIN: C3.P$2, C4.P$2, J3.P$2, U$2.P$2A

Notes on the sheet:
vin
pa4
pa5
pa7
rst
uart3
uart1

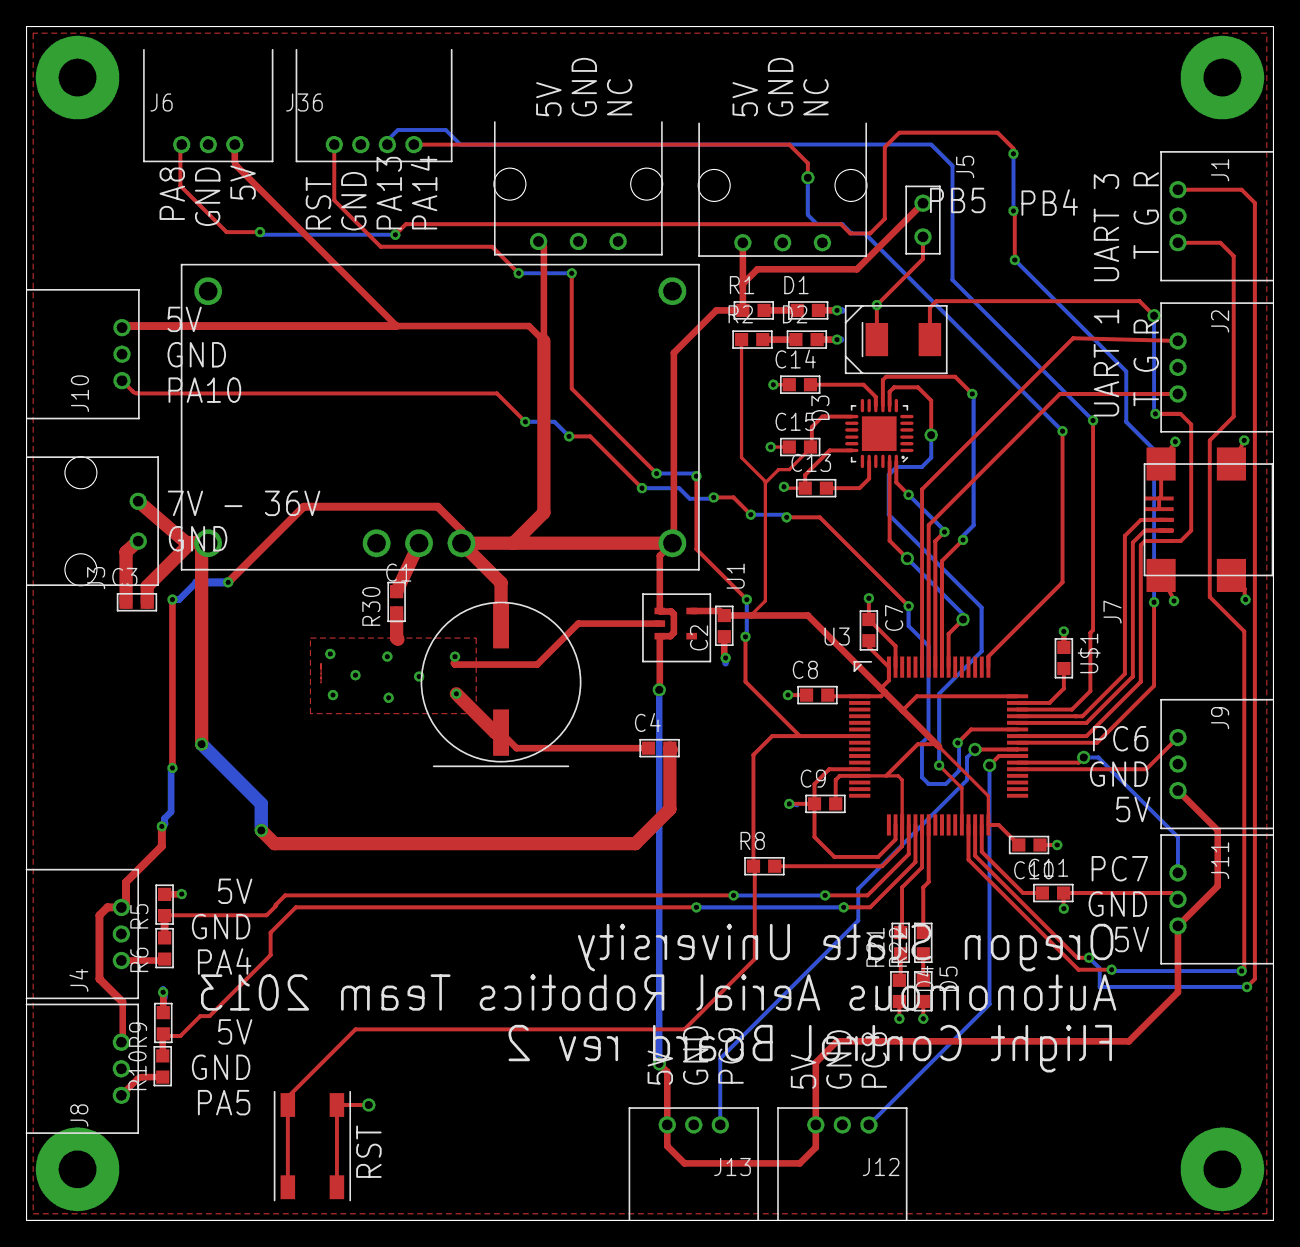
[picture p19: board was_not_root_aerialboard_rev1.brd from above]

Board: 2 copper layers, 94.0 x 90.0 mm, 49 parts (0 on the bottom side), 40 nets.
