OSURoboticsClub/aerial_avionics/flight_controller/rev3.4/mpubreakout.brd

## EAGLE design flight_controller/rev3.4/mpubreakout.brd (2014-11-05, an earlier design)

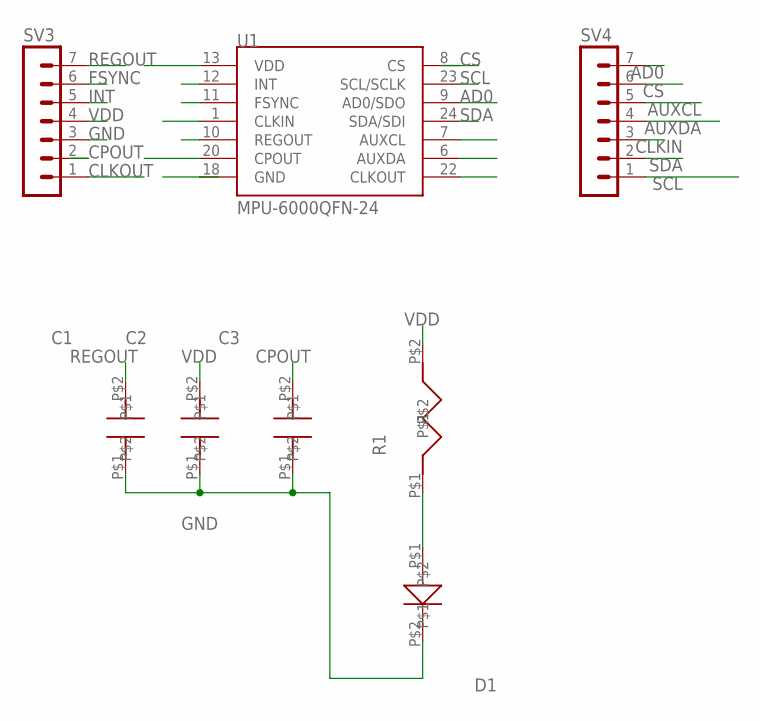
[picture p20: schematic mpubreakout.sch]

Parts:
C1, C2: CAPACITOR-.1UF-4V; 0603-CAPACITOR
C3: CAPACITOR-2.2NF-50V; 0603-CAPACITOR
D1: RED_LED; 0603-CAPACITOR
R1: RESISTOR-4.7K-25V; 0603-CAPACITOR
SV3, SV4: MA07-1
U1: MPU-6000QFN-24; QFN-24-TESTING

Connections:
AD0: SV4.7, U1.9 (AD0/SDO)
AUXCL: SV4.5, U1.7 (AUXCL)
AUXDA: SV4.4, U1.6 (AUXDA)
CLKIN: SV4.3, U1.1 (CLKIN)
CLKOUT: SV3.1, U1.22 (CLKOUT)
CPOUT: C3.P$2, SV3.2, U1.20 (CPOUT)
CS: SV4.6, U1.8 (CS)
FSYNC: SV3.6, U1.11 (FSYNC)
GND: C1.P$1, C2.P$1, C3.P$1, D1.P$2, SV3.3, U1.18 (GND)
INT: SV3.5, U1.12 (INT)
unnamed: D1.P$1, R1.P$1
REGOUT: C1.P$2, SV3.7, U1.10 (REGOUT)
SCL: SV4.1, U1.23 (SCL/SCLK)
SDA: SV4.2, U1.24 (SDA/SDI)
VDD: C2.P$2, R1.P$2, SV3.4, U1.13 (VDD)

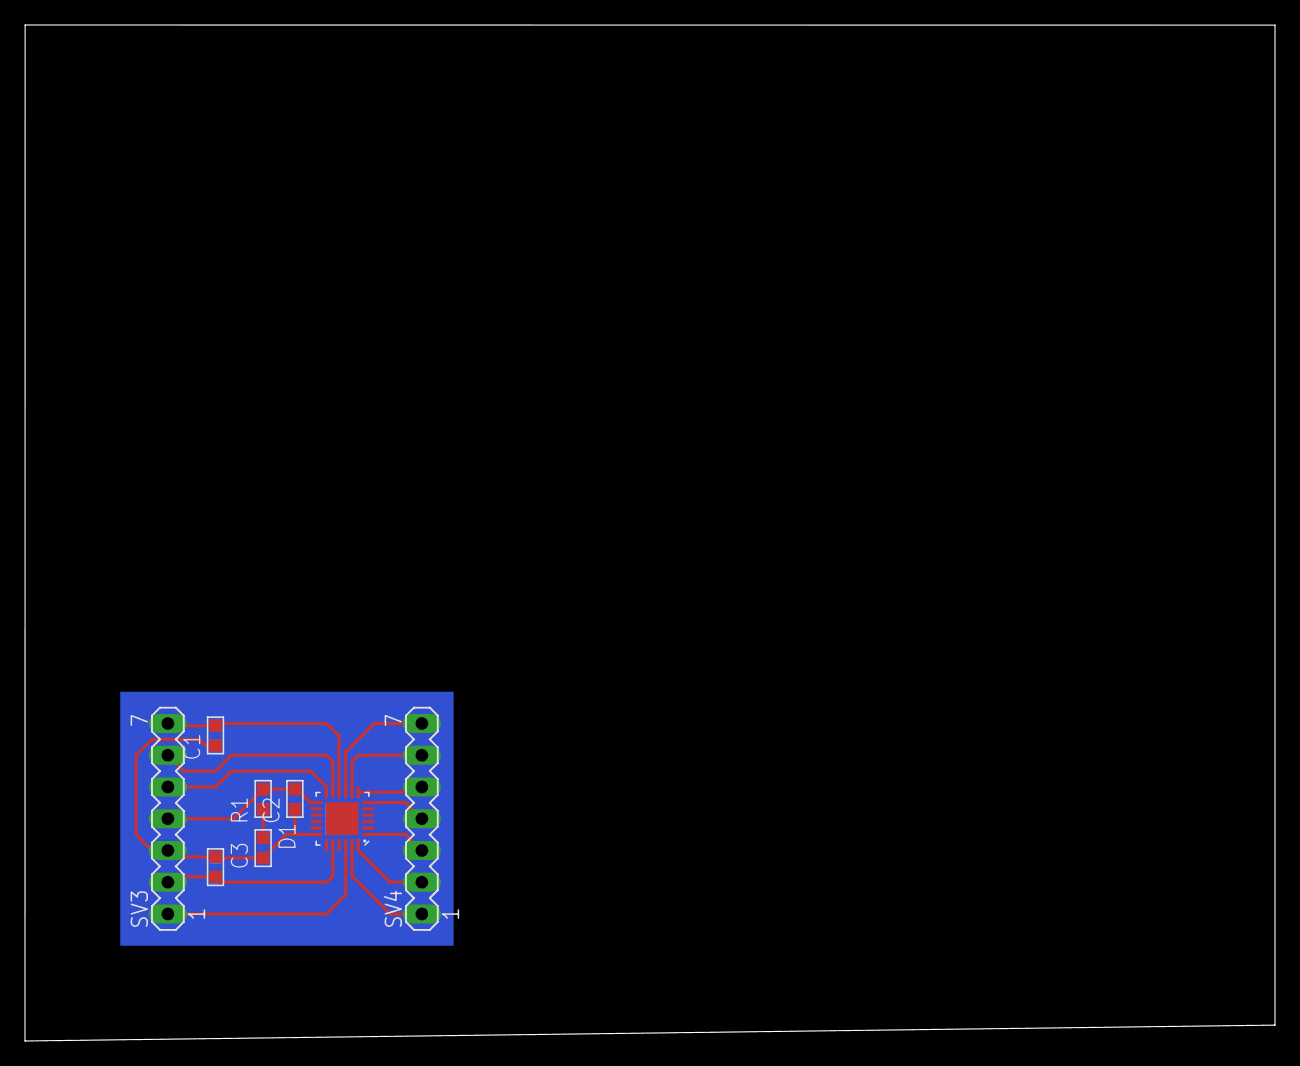
[picture p21: board mpubreakout.brd from above]

Board: 2 copper layers, 100.0 x 81.3 mm, 8 parts (0 on the bottom side), 15 nets.
