OSURoboticsClub/aerial_avionics/(commit log)

2014-11-05 Add FC board revs 0, 1, 2, and 3.4.
    [fc_board_rev_1.brd, fc_board_rev_1.sch, mpubreakout.brd, mpubreakout.sch, rev3.brd, rev3.sch, was_not_root_aerialboard_rev1.brd, was_not_root_aerialboard_rev1.sch]
2014-11-05 Add ESC rev1.
    [esc_mod1_p1.pcb, esc_mod1_p1.sch, esc_mod1_p2.sch]
2014-11-05 Add ESC rev2.
    [esc_mod1_p2.pcb, esc_mod1_p2.sch]
2014-12-15 Copy rev3.4 to core.{brd,sch}.
    This will be our version-controlled copy of the board.
    [core.brd, core.sch]
2014-12-16 Start reorganizing. F4 logic power copied.
    Need to verify this was correct to begin with.
    [core.brd, core.sch]
2014-12-17 Redraw schematics for PWM, ADC, SWD.
    [core.brd, core.sch]
2014-12-17 Split F4 into GPIO and POWER subcomponents.
    [core.brd, core.sch]
2014-12-18 Move things around.
    [core.sch]
2014-12-18 Replace Incorrect Parts
    [core.brd, core.sch]
2014-12-18 Add LEDs for F4, XBee, power.
    [core.brd, core.sch]
2014-12-18 Added Capacitor to 3.3V Regulator
    [core.brd, core.sch]
2014-12-18 Clean up 3.3V reg.
    [core.brd, core.sch]
2014-12-18 ADD DEBUG LEDS
    EDA does not lend itself to easy version control.
    [core.brd, core.sch]
2014-12-18 Add Kill BJTs, reset button, uSD and USB connectors.
    [core.brd, core.sch]
2014-12-18 Add more LEDs.
    [core.brd, core.sch]
2014-12-18 Update connectors and start drawing SPI/I2C breakout.
    Hella progress yo.
    [core.brd, core.sch]
2014-12-18 Add MPU-6000, more bypass caps, replace various packages for consistency.
    [core.brd, core.sch]
2014-12-19 Add some missing junctions.
    [core.brd, core.sch]
2014-12-19 Add MS5611 circuit and SPI and I2C pullup/down resistors.
    [core.brd, core.sch]
2014-12-19 Rename some nets.
    [core.brd, core.sch]
2014-12-19 Add oscillator.
    [core.brd, core.sch]
2014-12-21 Replace XBee headers with SMD variant.
    [core.brd, core.sch]
2014-12-21 Reassign and rename UART buses to XBee and GPS.
    [core.brd, core.sch]
2014-12-21 Explicitly name XBee package.
    [core.brd, core.sch]
2014-12-21 Remove XBee reset pin from global reset net.
    The XBee pin is for factory resetting the device! Read the datasheet, people!
    [core.brd, core.sch]
2014-12-21 Add RGB status LED pair.
    [core.brd, core.sch]
2014-12-22 Replace components to those from new OSURC libraries.
    [core.brd, core.sch]
2014-12-22 Change kill BJTs to dual N-ch MOSFETs.
    [core.brd, core.sch]
2014-12-22 Replace LED MOSFETs with dual-channel MOSFETs.
    [core.brd, core.sch]
2014-12-26 Remove 5V regulator todo and add reverse voltage protection.
    Board will need 5V input from external regulator.
    [core.brd, core.sch]
2014-12-27 Add TVS/RVP circuit.
    [core.brd, core.sch]
2014-12-27 Implement MPU-9250.
    [core.brd, core.sch]
2014-12-27 Move some things around.
    [core.sch]
2014-12-29 Add digital I/O pins, remove some LEDs, rearrange stuff.
    [core.brd, core.sch]
2014-12-29 Resolve most ERC errors.
    Two warnings for unused F4's B12 and C15.
    [core.brd, core.sch]
2014-12-29 Renumber schematic.
    [core.brd, core.sch]
2014-12-31 Add test points.
    [core.brd, core.sch]
2014-12-31 Update connectors with those from OSURC libs.
    Dunno how these didn't get updated last time.
    [core.brd, core.sch]
2014-12-31 Correct symbol placement.
    [core.brd, core.sch]
2014-12-31 Start layout.
    [core.brd, core.sch]
2014-12-31 Connect KILL with a stray KILL1 net.
    [core.brd, core.sch]
2014-12-31 Remove value from MPU footprint.
    [core.brd, core.sch]
2015-01-01 Move USB 5V to VIN.
    [core.brd, core.sch]
2015-01-01 Make last two PWM outputs 5V powered (for servos).
    [core.brd, core.sch]
2015-01-01 Component placement almost done, routing halfway done.
    [core.brd, core.sch]
2015-01-01 More layout, and replace passives with OSURC's own.
    [core.brd, core.sch]
2015-01-01 Layout 70% done with new 8MHz crystal.
    [core.brd, core.sch]
2015-01-02 FC layout 90% done.
    [core.brd, core.sch]
2015-01-02 Resolve all errors and finish routing.
    [core.brd, core.sch]
2015-01-05 Space out some unnecessarily closely-spaced traces.
    [core.brd]
2015-01-12 Add USB diffpair net class and USB termination resistors.
    [core.brd, core.sch]
2015-01-12 Place USB termination resistors.
    [core.brd, core.sch]
2015-01-12 Finish up.
    [core.brd]
2015-01-12 Place new uSD socket and LEDs.
    [core.brd, core.sch]
2015-01-12 Place testpoint labels properly.
    [core.brd]
2015-01-12 Add gyro axis indicator on silkscreen.
    [core.brd]
2015-01-12 Add note on board thickness.
    [core.brd]
2015-01-13 Add missing trace.
    Dunno how that went missing.
    [core.brd]
2015-01-13 Swap out MIC5219 3.3V linreg with our own symbol.
    [core.brd, core.sch]
2015-01-13 Use own XBee symbol.
    [core.brd, core.sch]
2015-01-14 Place new USB connector.
    [core.brd, core.sch]
2015-01-14 Remove some resolved todos.
    [core.sch]
2015-01-14 Update USB connector.
    [core.brd, core.sch]
2015-01-14 Add more silkscreen guides.
    [core.brd]
2015-01-15 Tweak silkscreen.
    [core.brd]
2015-01-24 Start FCv4.0 in Altium.
    [Cover.SchDoc, FC.PcbDoc, Flight_Controller.PrjPCB, Logic.SchDoc, Power.SchDoc]
2015-01-24 Add cover properly.
    [Cover.SchDoc, Flight_Controller.PrjPCB]
2015-01-24 Copy F4 pin config.
    [FC.PcbDoc, Flight_Controller.PrjPCB, Logic.SchDoc]
2015-03-20 Add Drake's power distribution board schematics and beginnings of layout.
    [osuar_pdb.brd, osuar_pdb.sch]
2015-03-20 Add extra Vin connector to pdb schematic
    [osuar_pdb.brd, osuar_pdb.sch]
2016-01-24 Remove old altium version of v4.0
    [Cover.SchDoc, FC.PcbDoc, Flight_Controller.PrjPCB, Logic.SchDoc, Power.SchDoc]
2016-01-24 Fix MPU-9250 footprint.
    [core.brd, core.sch]
2016-01-24 Add FC v3.9.1.
    This fixes the bad MPU-9250 footprint.
    [core.brd, core.sch]
